jeffsponaugle/rsc68k/documents/FLIR0329.jpg

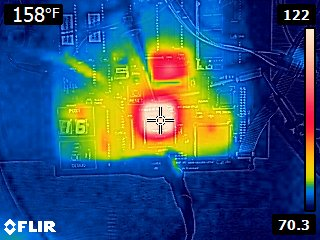
documents/FLIR0329.jpg
