jeffsponaugle/rsc68k/documents/AN-1259_System_Design_and_Layout_Techniques_for_Noise_reduction_in_MCU-based_systems.pdf

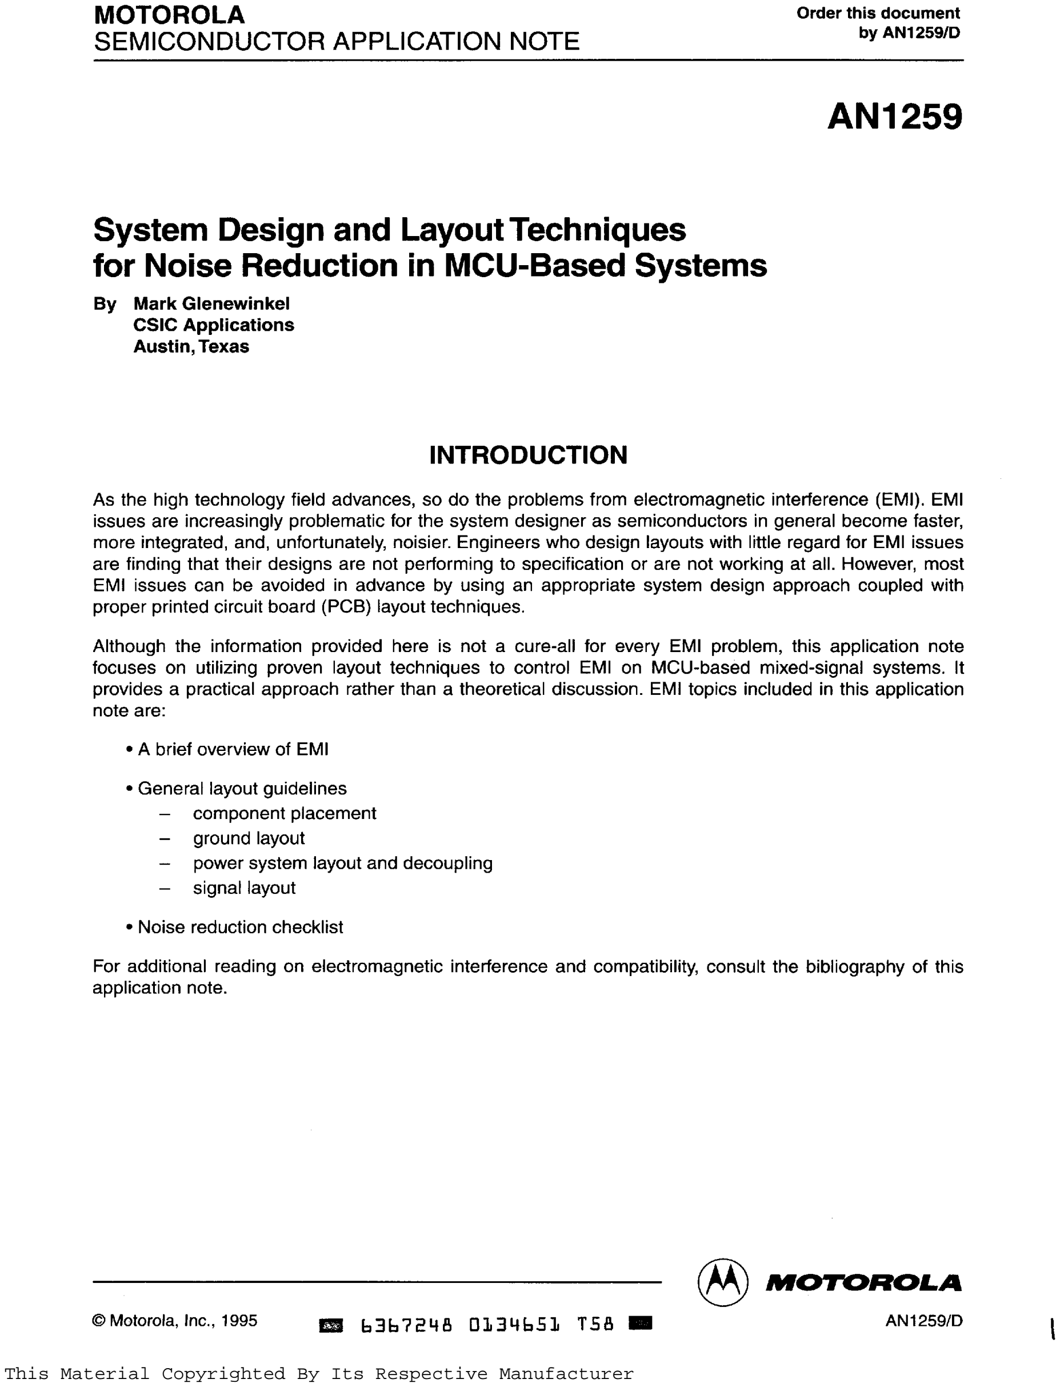
[picture p3: page 1]

This Material Copyrighted By Its Respective Manufacturer

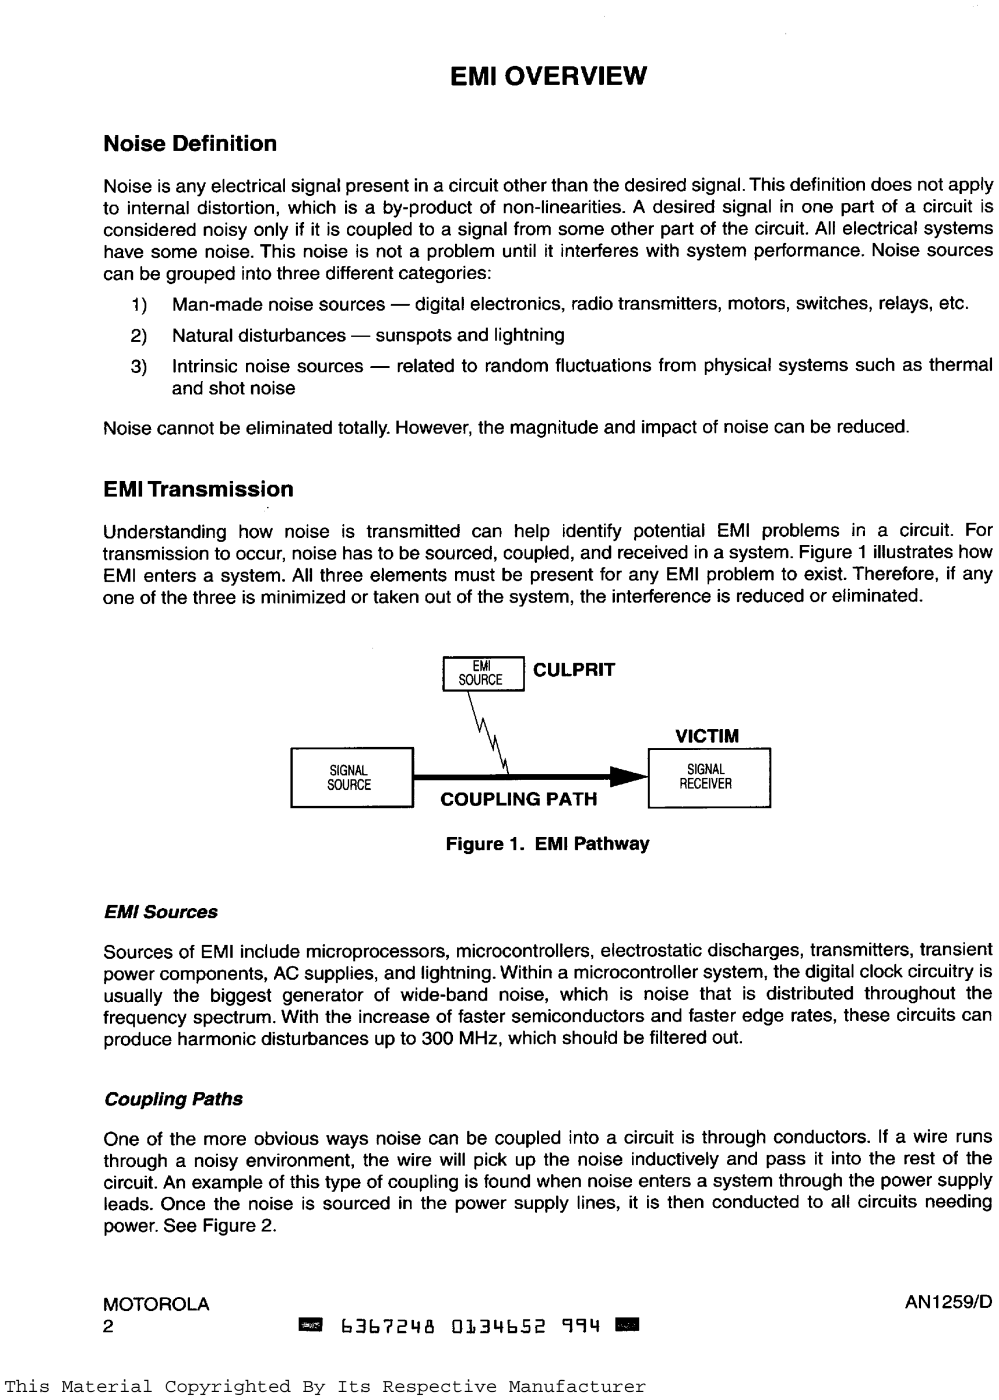
[picture p4: page 2]
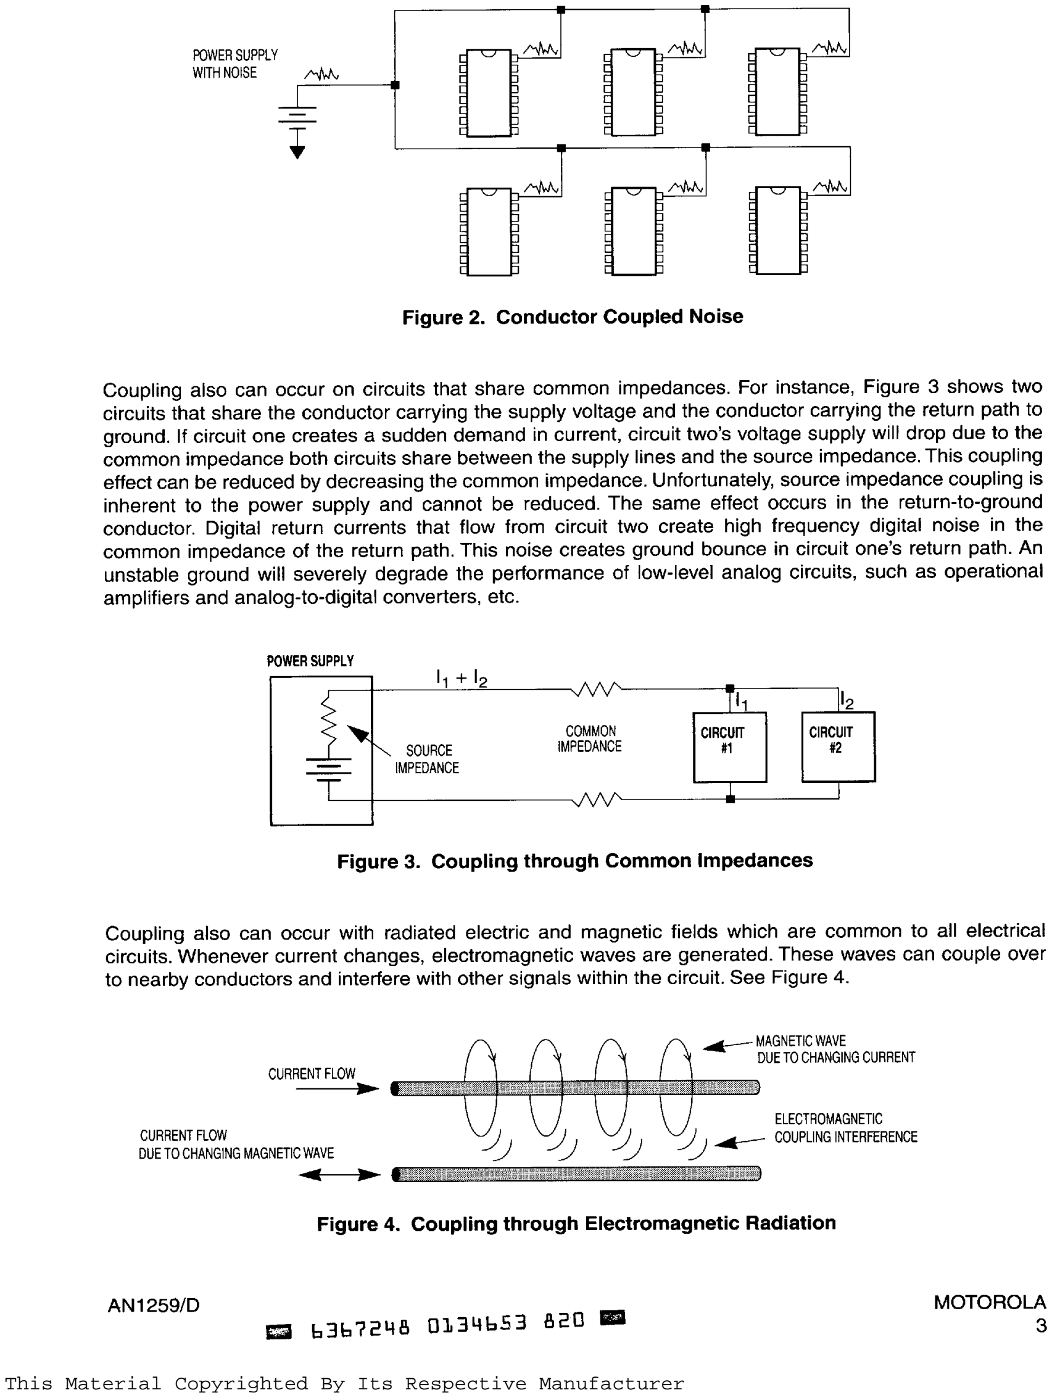
[picture p5: page 3]
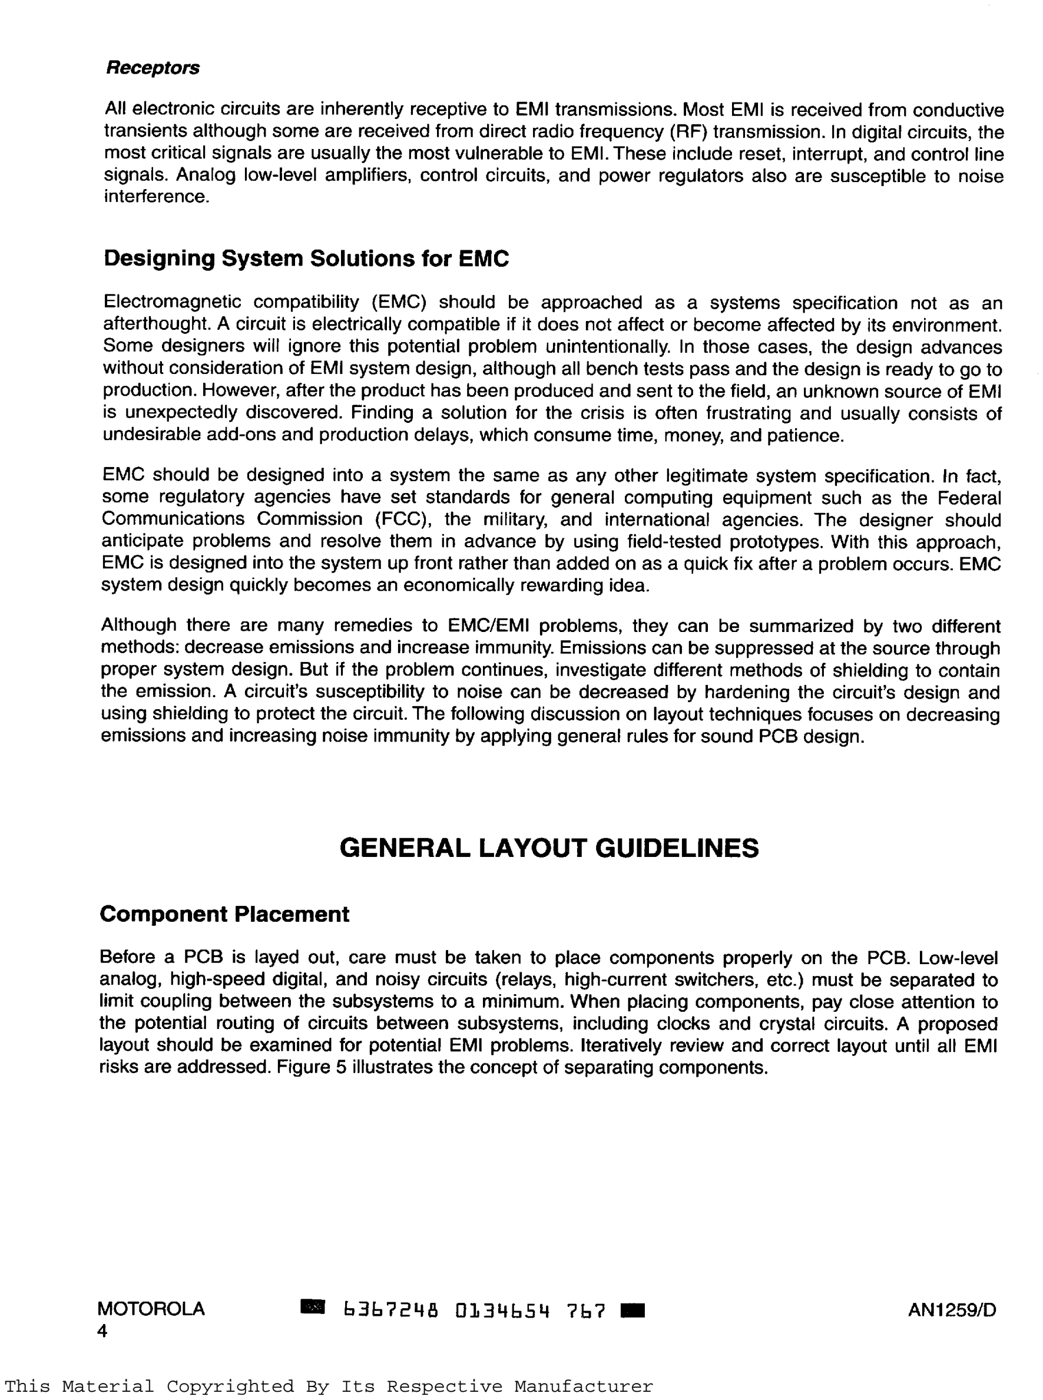
[picture p6: page 4]
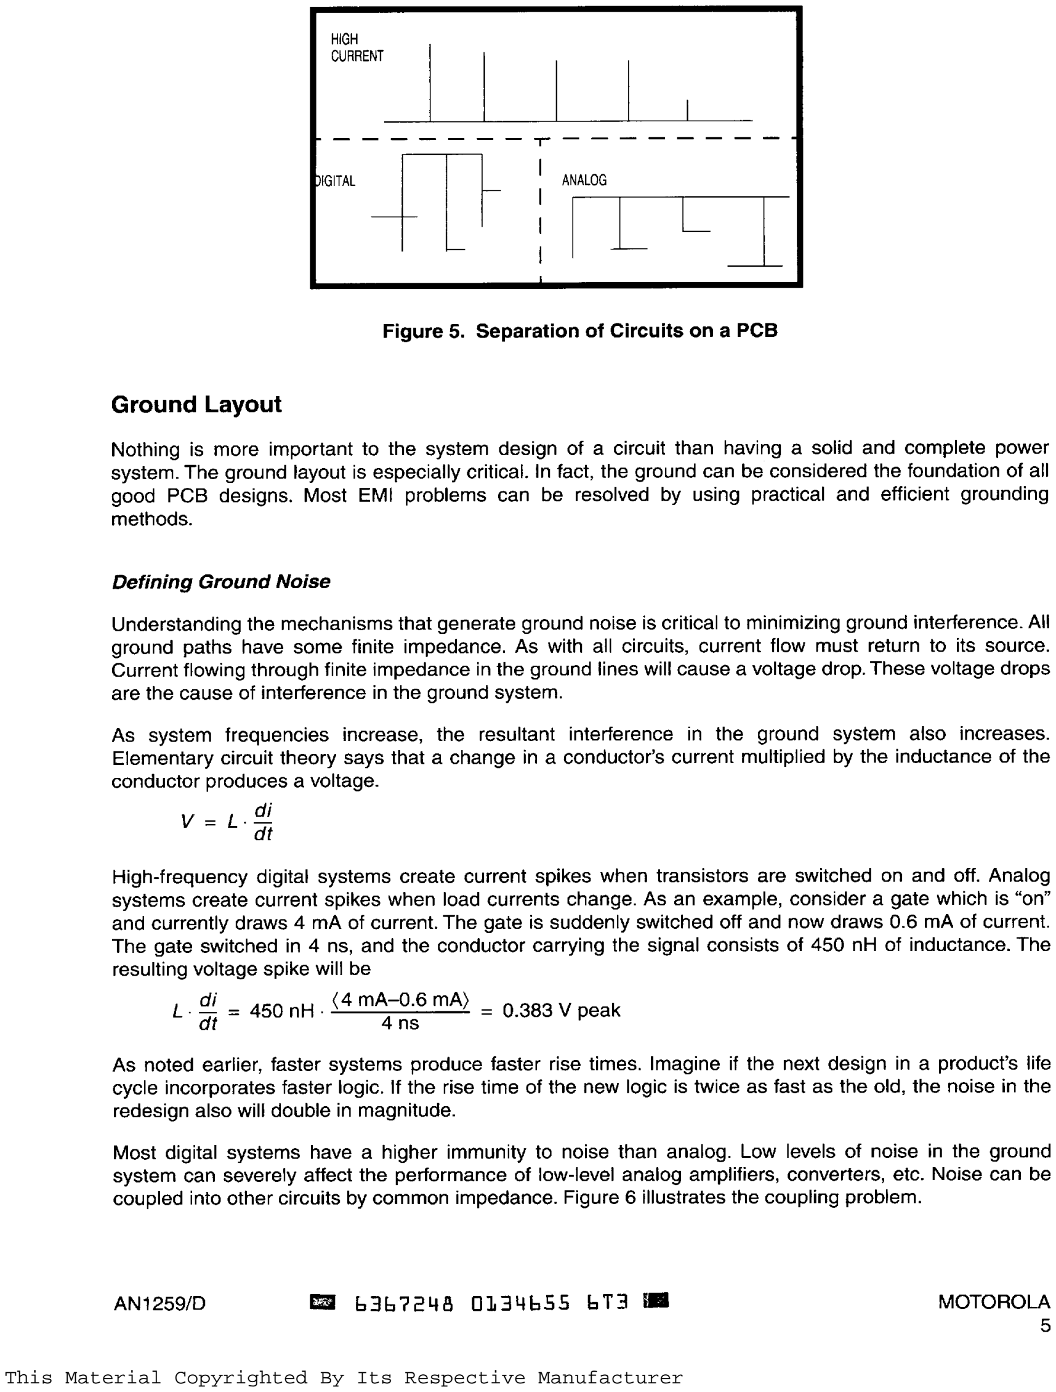
[picture p7: page 5]
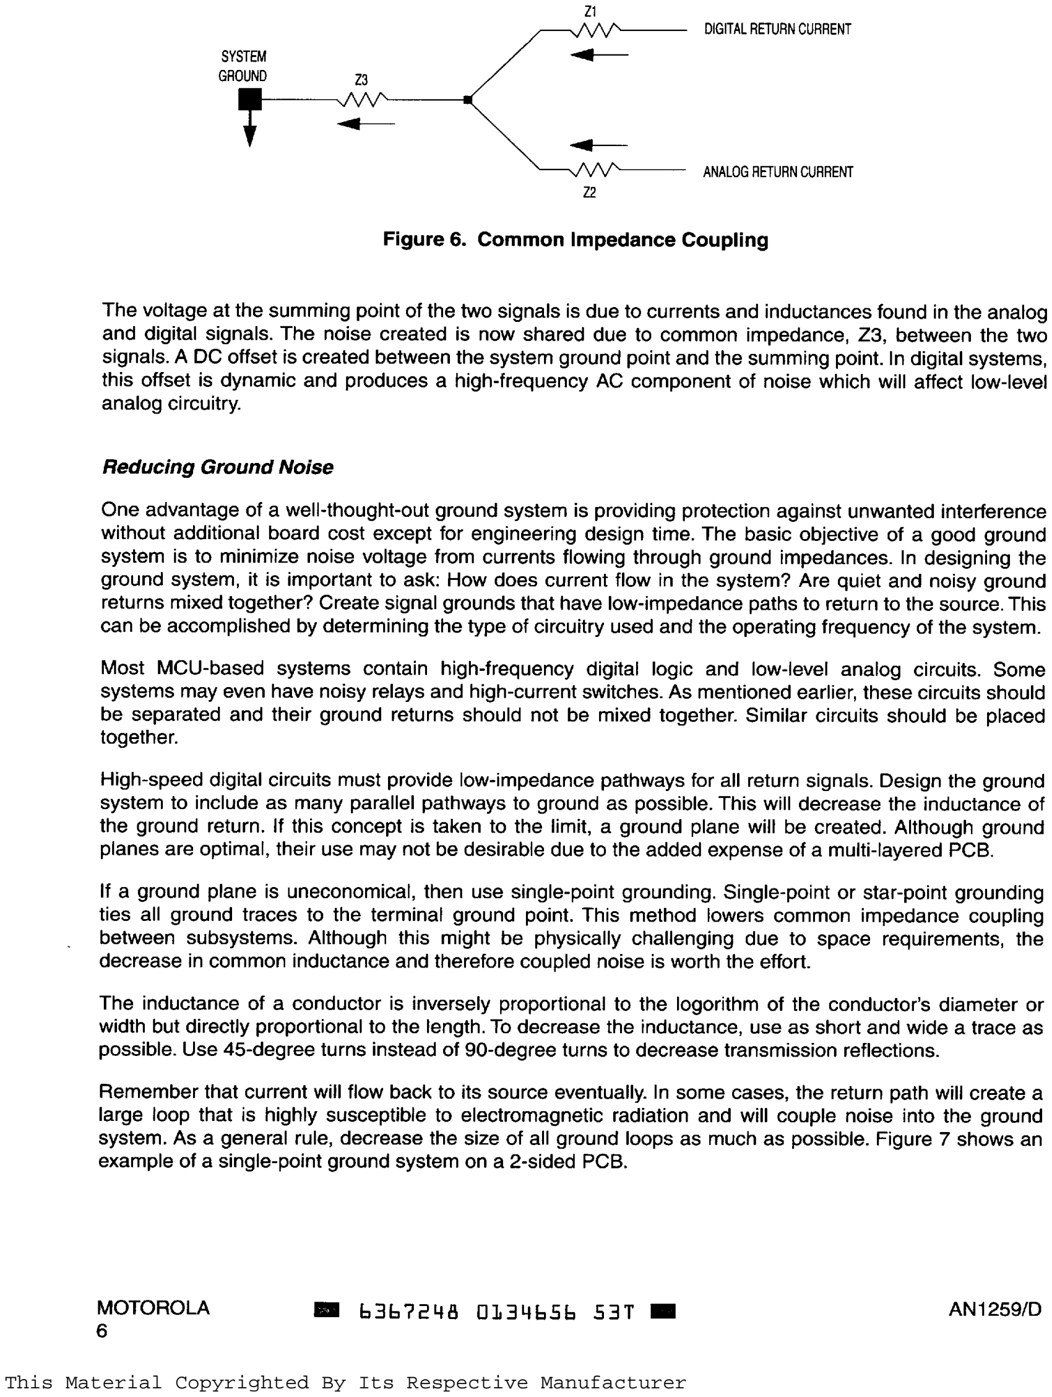
[picture p8: page 6]
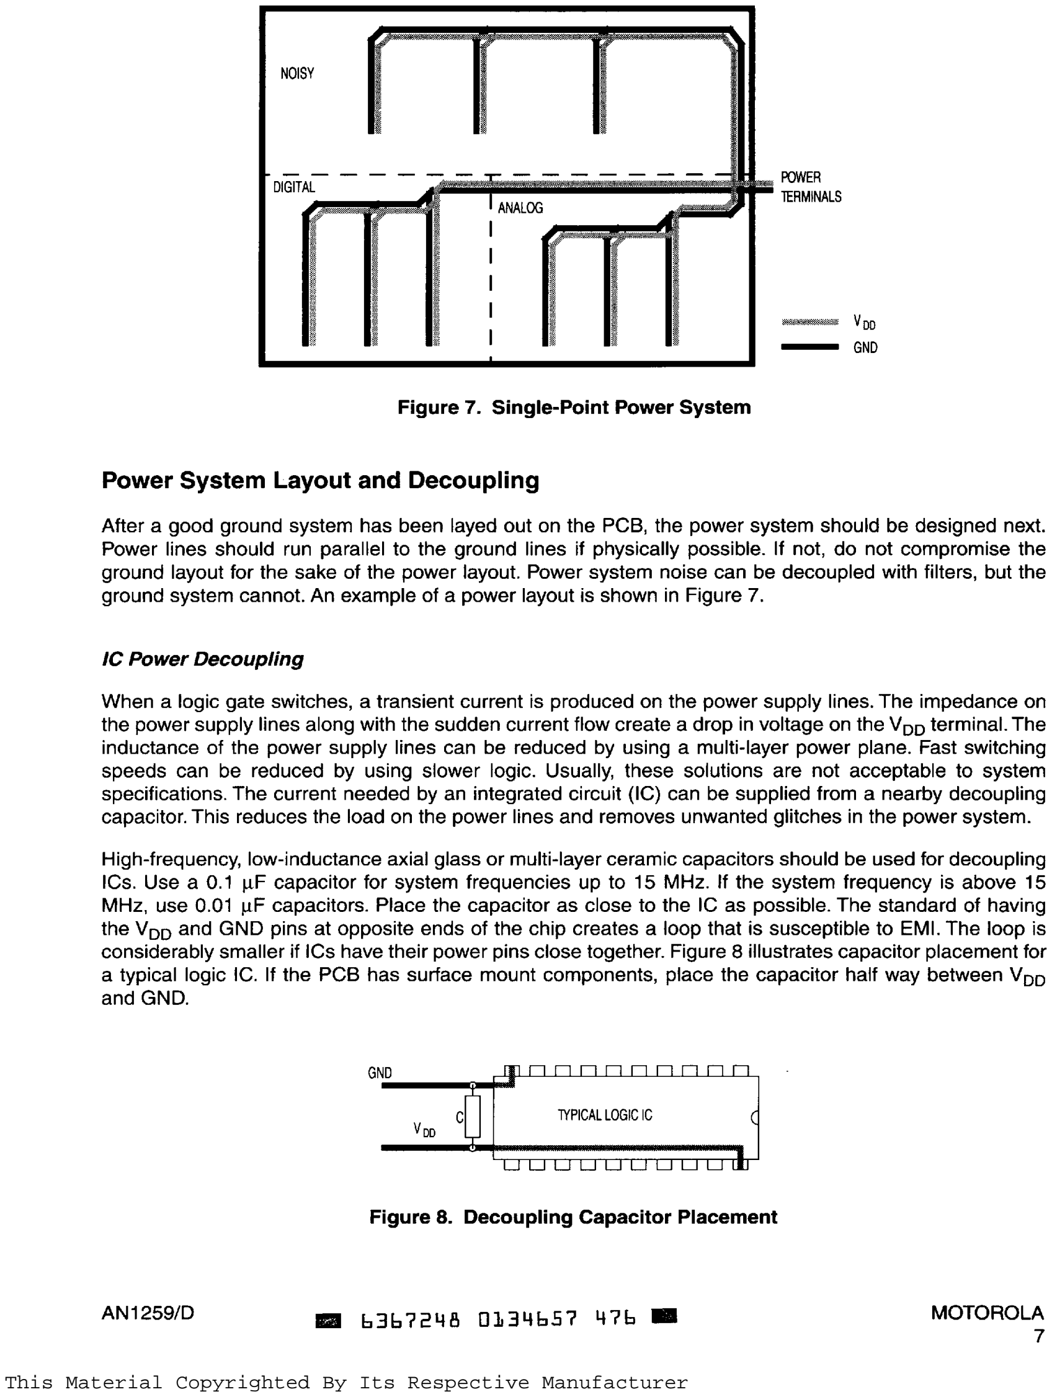
[picture p9: page 7]
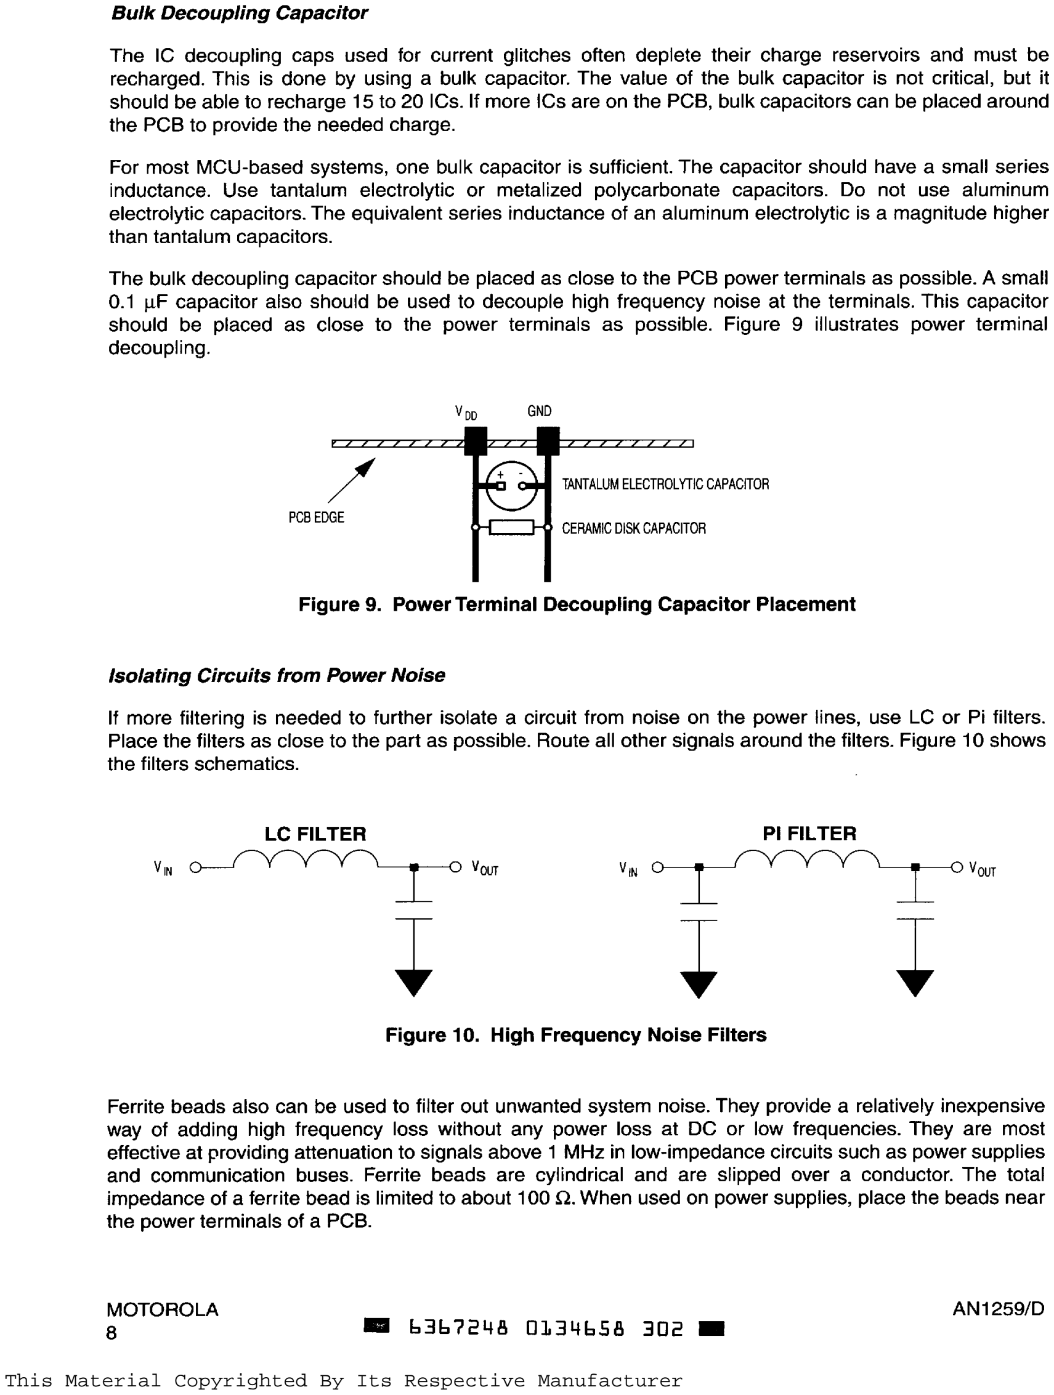
[picture p10: page 8]
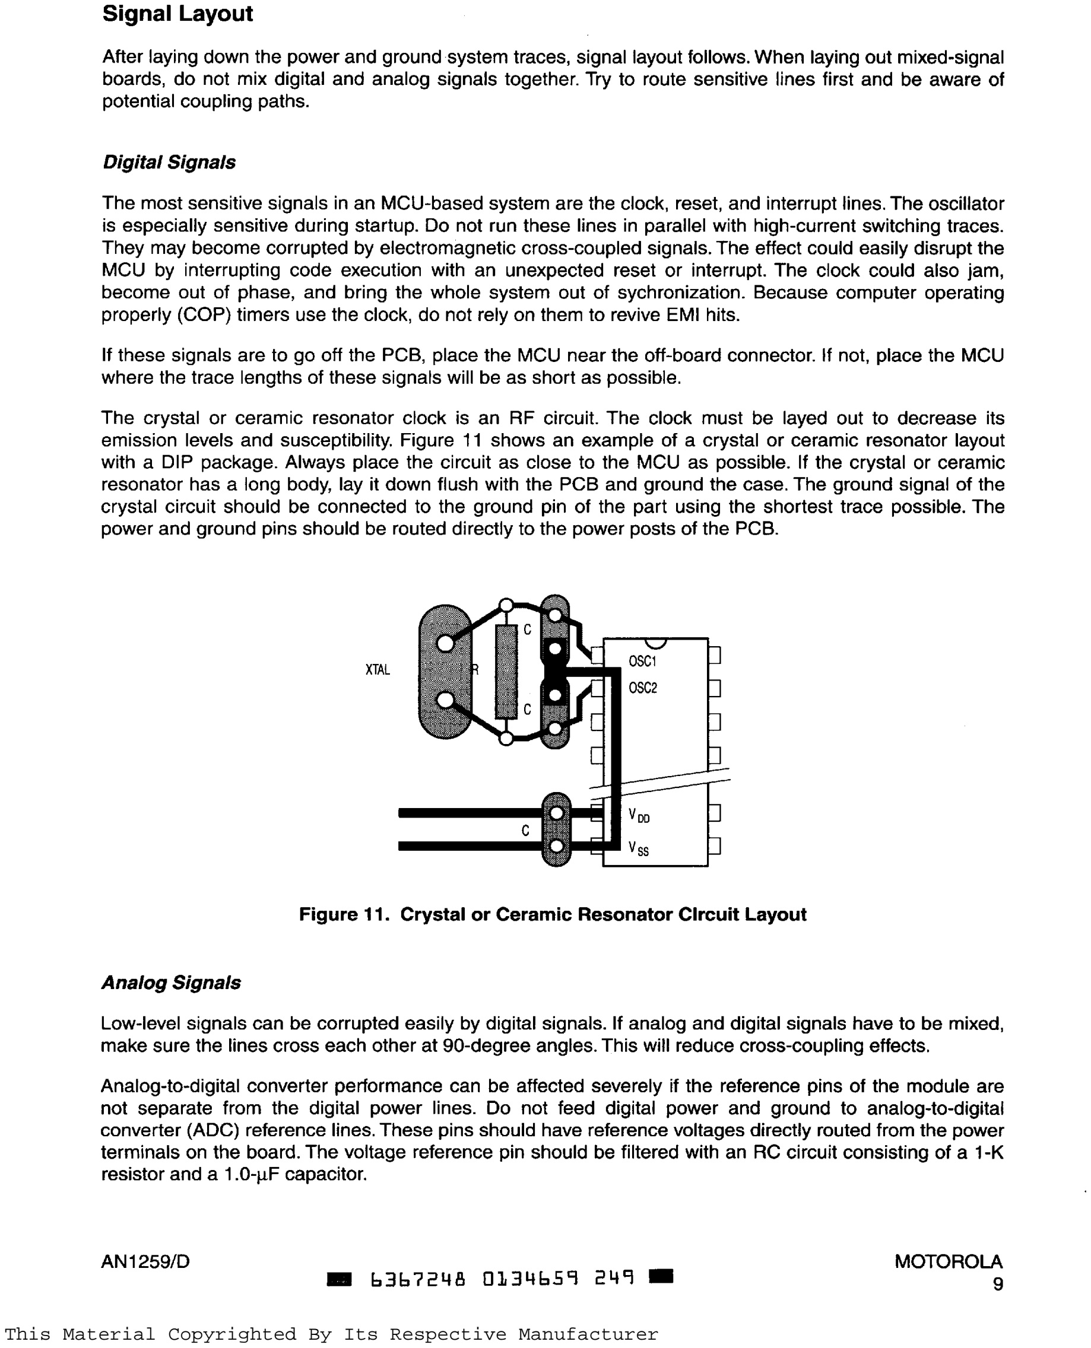
[picture p11: page 9]
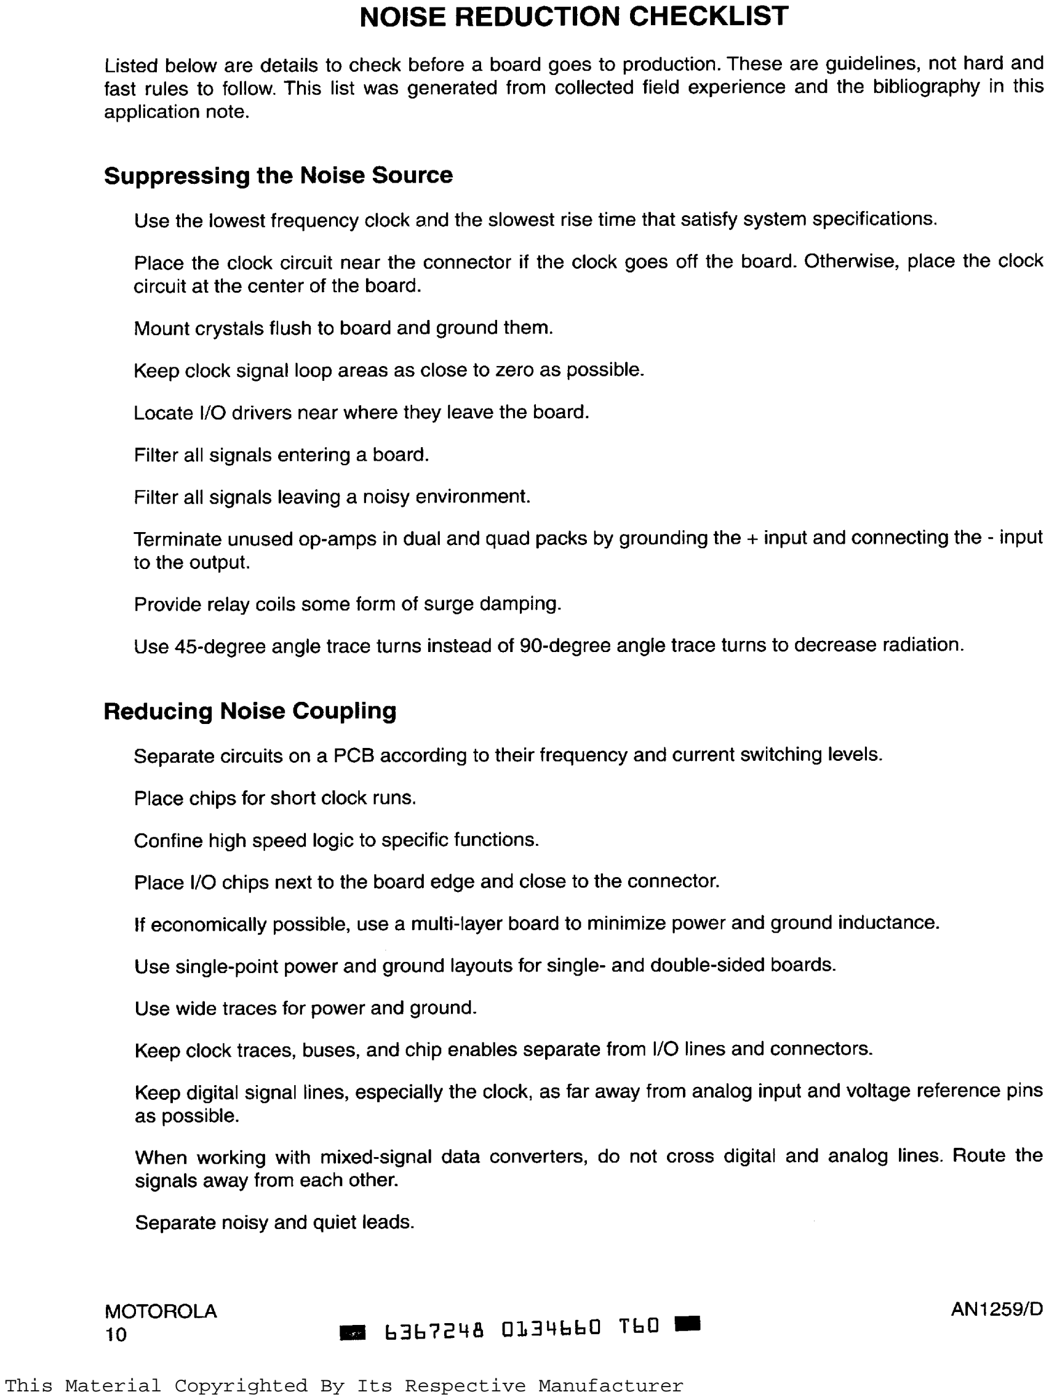
[picture p12: page 10]
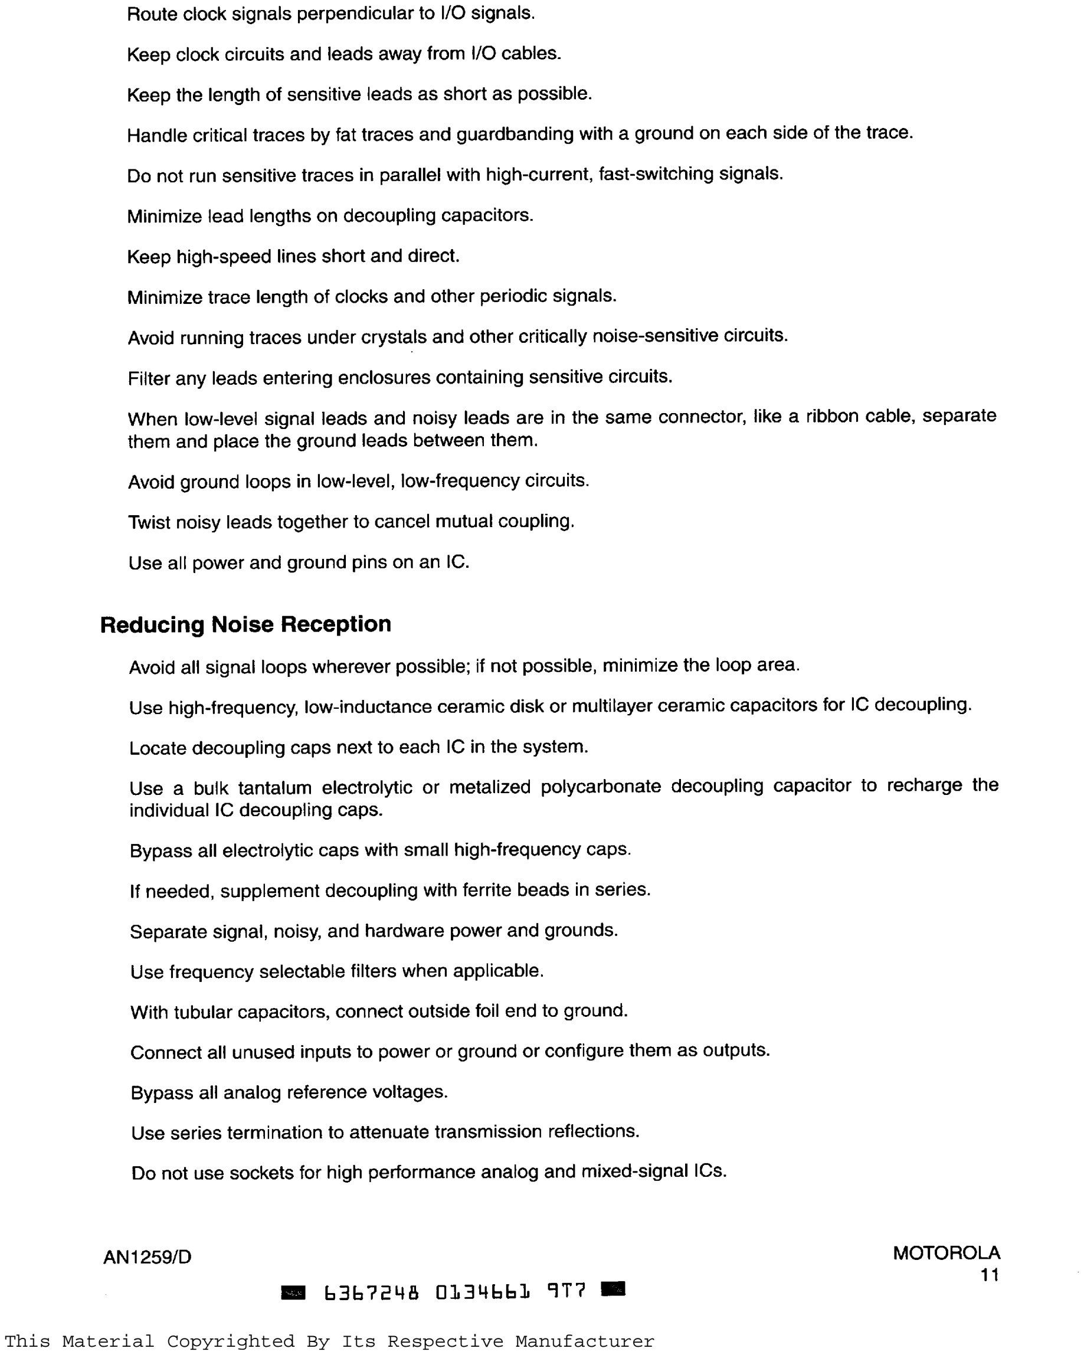
[picture p13: page 11]
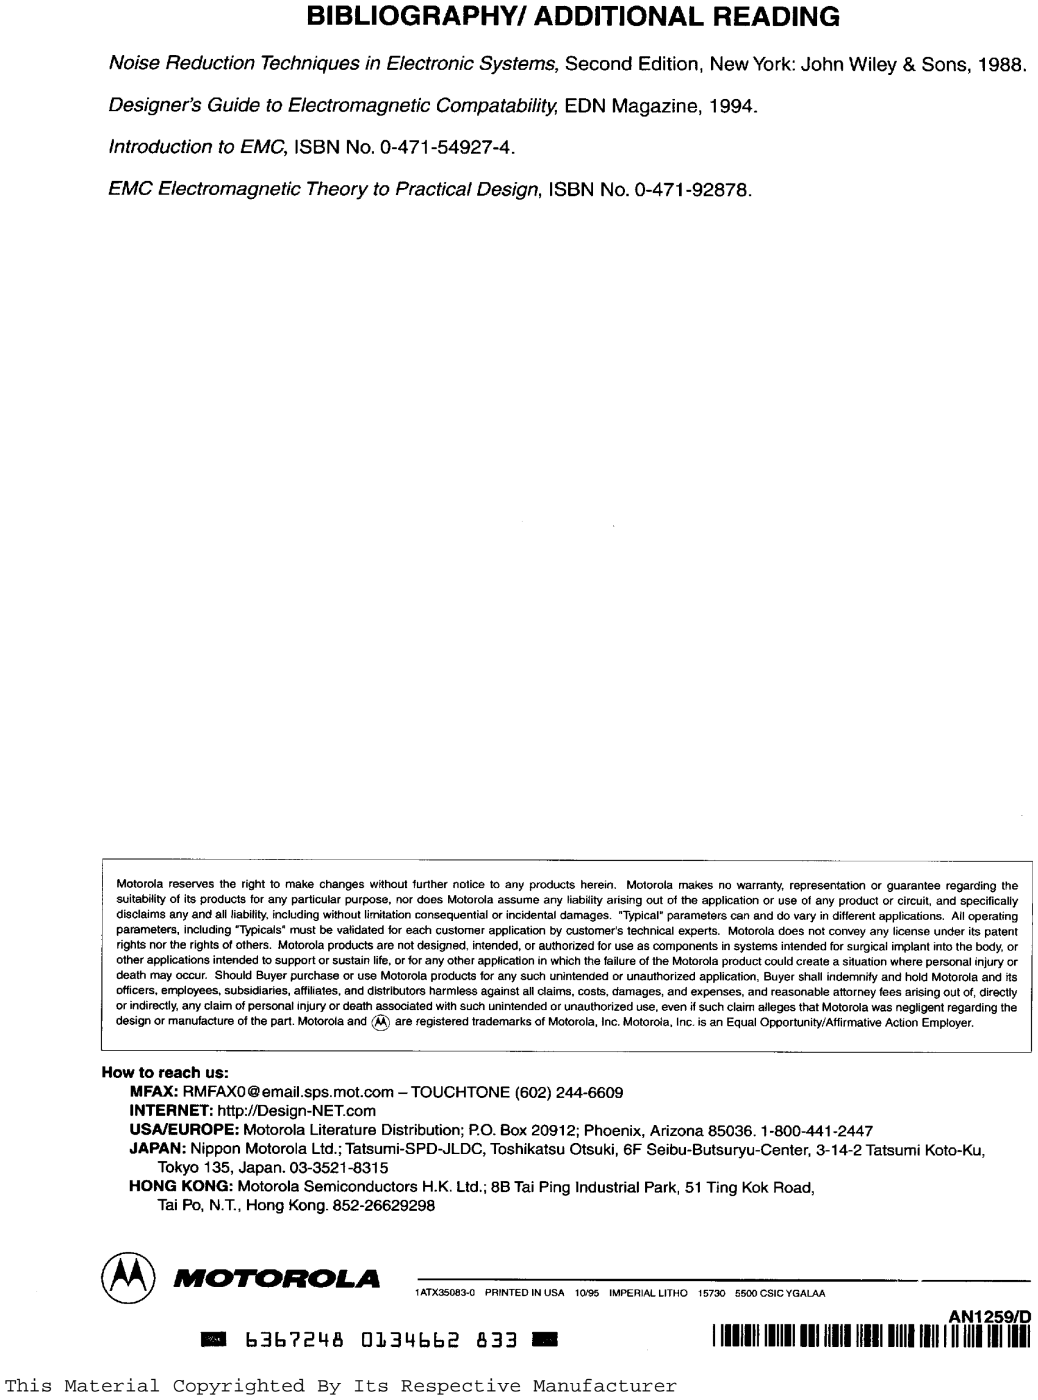
[picture p14: page 12]
