jeffsponaugle/rsc68k/documents/500-PLCC-28-32_eng_tds.pdf

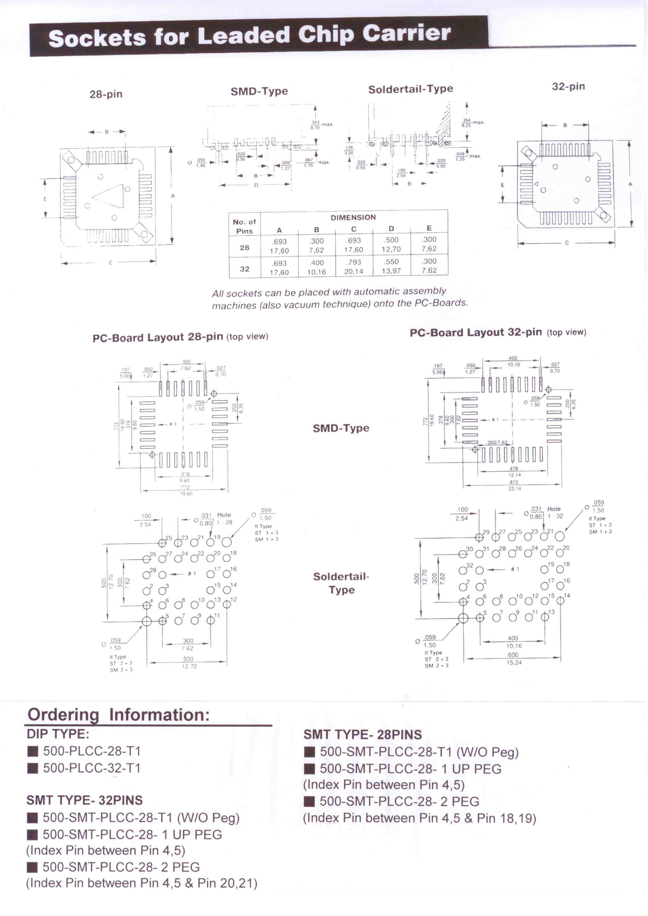
[picture p15: page 1]
