jeffsponaugle/rsc68k/cpld/ATXBoardV1/BRIDGE_CPLD/scope/C32-C16-REFGNT-CPU0REQ.png

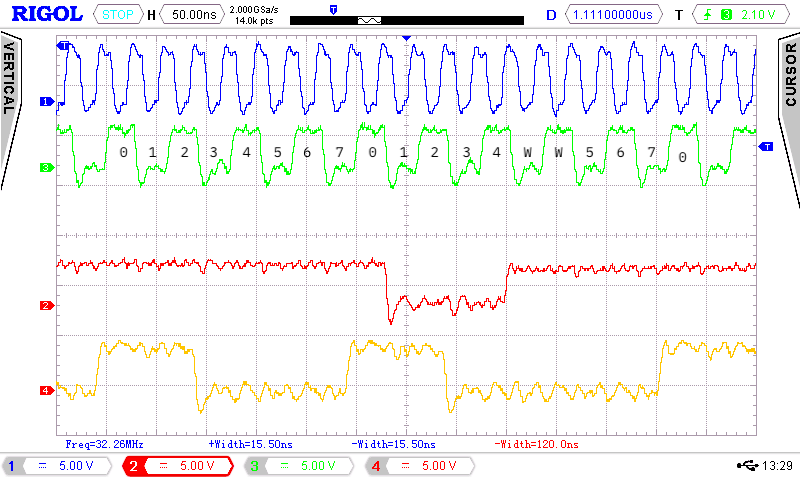
cpld/ATXBoardV1/BRIDGE_CPLD/scope/C32-C16-REFGNT-CPU0REQ.png
