jeffsponaugle/rsc68k/cpld/ATXBoardV1/BRIDGE_CPLD/scope/CLK16-AS-RGNT-CGNTd.png

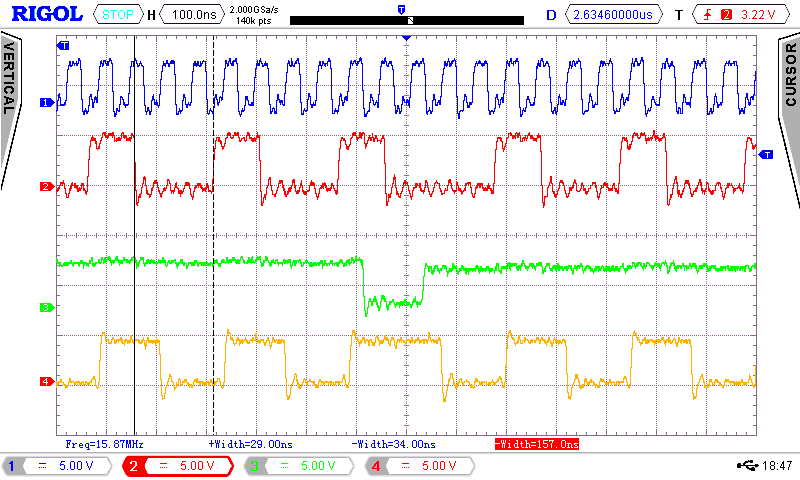
cpld/ATXBoardV1/BRIDGE_CPLD/scope/CLK16-AS-RGNT-CGNTd.png
