jeffsponaugle/rsc68k/cpld/ATXBoardV1/BRIDGE_CPLD/scope/CLK16-AS-RGNT-CGNTf.png

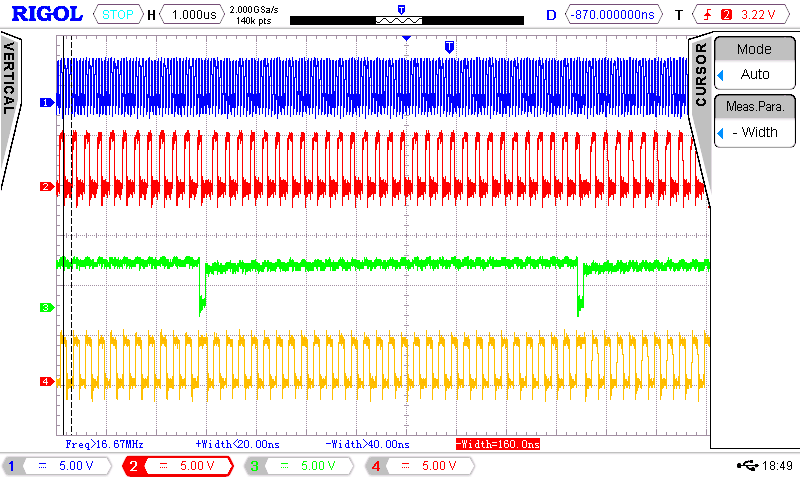
cpld/ATXBoardV1/BRIDGE_CPLD/scope/CLK16-AS-RGNT-CGNTf.png
