jeffsponaugle/rsc68k/cpld/ATXBoardV1/BRIDGE_CPLD/scope/CLK32-AS-REQ-GNTa1.png

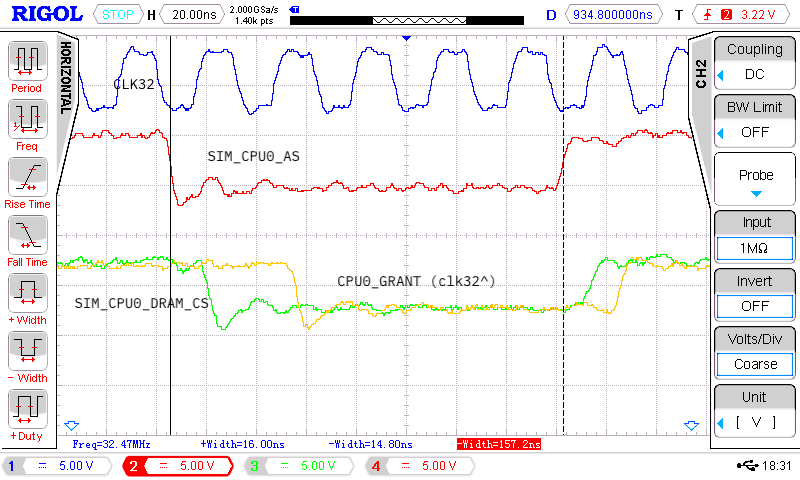
cpld/ATXBoardV1/BRIDGE_CPLD/scope/CLK32-AS-REQ-GNTa1.png
