jeffsponaugle/rsc68k/cpld/ATXBoardV1/BRIDGE_CPLD/scope/CLK32-AS-RGNT-CGNTa.png

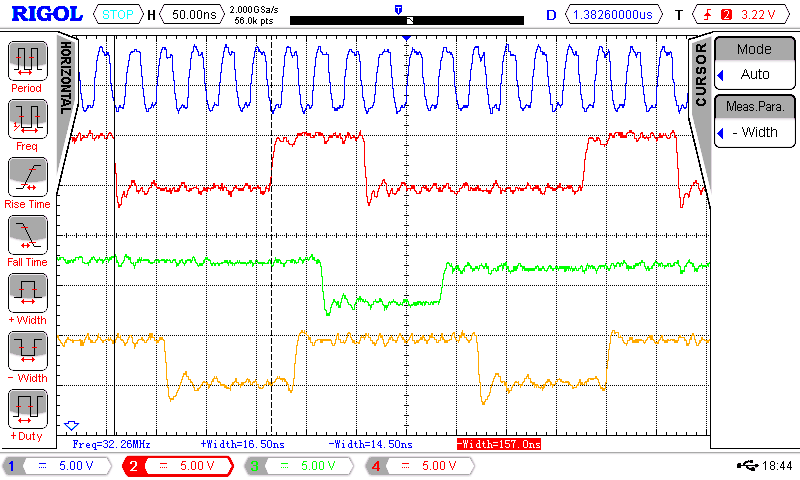
cpld/ATXBoardV1/BRIDGE_CPLD/scope/CLK32-AS-RGNT-CGNTa.png
