jeffsponaugle/rsc68k/cpld/ATXBoardV1/BRIDGE_CPLD/scope/CLK-AS-REQ-GNTb.png

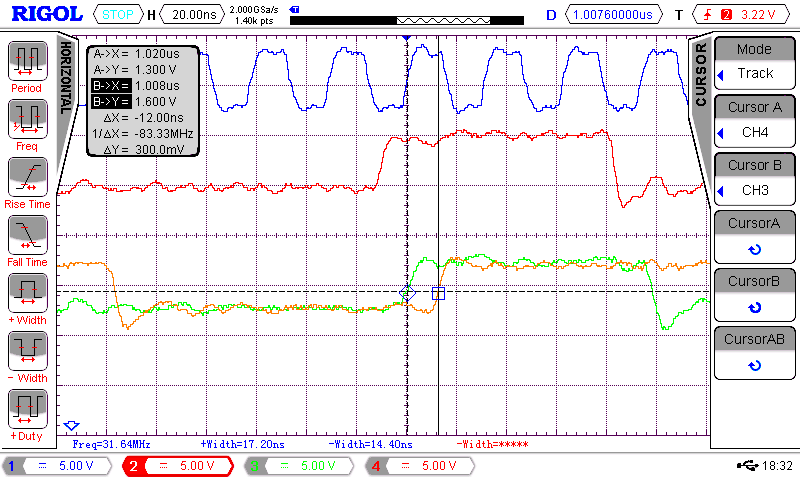
cpld/ATXBoardV1/BRIDGE_CPLD/scope/CLK-AS-REQ-GNTb.png
