jeffsponaugle/rsc68k/documents/16MhzDRAMREFESH1.png

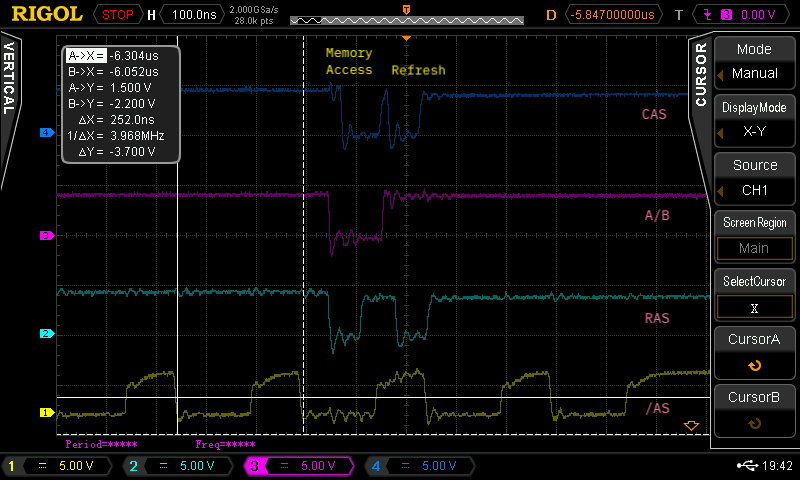
documents/16MhzDRAMREFESH1.png
