jeffsponaugle/rsc68k/documents/16MhzDRAMREFRESH2.png

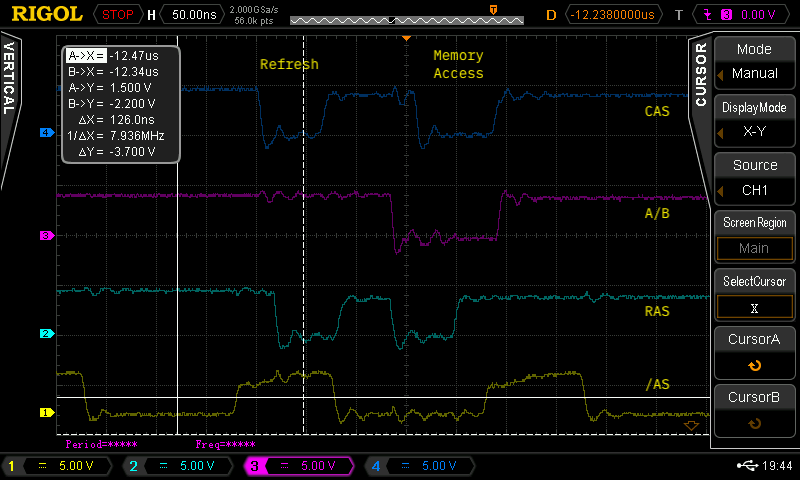
documents/16MhzDRAMREFRESH2.png
