jeffsponaugle/rsc68k/documents/42258354_10155493502805047_6035253907939131392_n (1).jpg

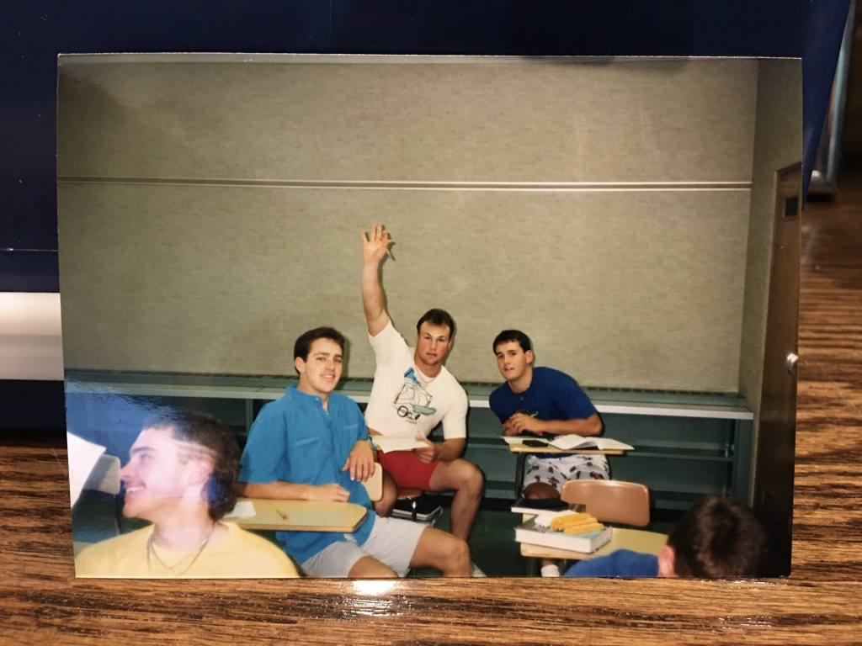
documents/42258354_10155493502805047_6035253907939131392_n (1).jpg
