jeffsponaugle/rsc68k/documents/42274475_10217530068780495_6191780692506968064_n.jpg

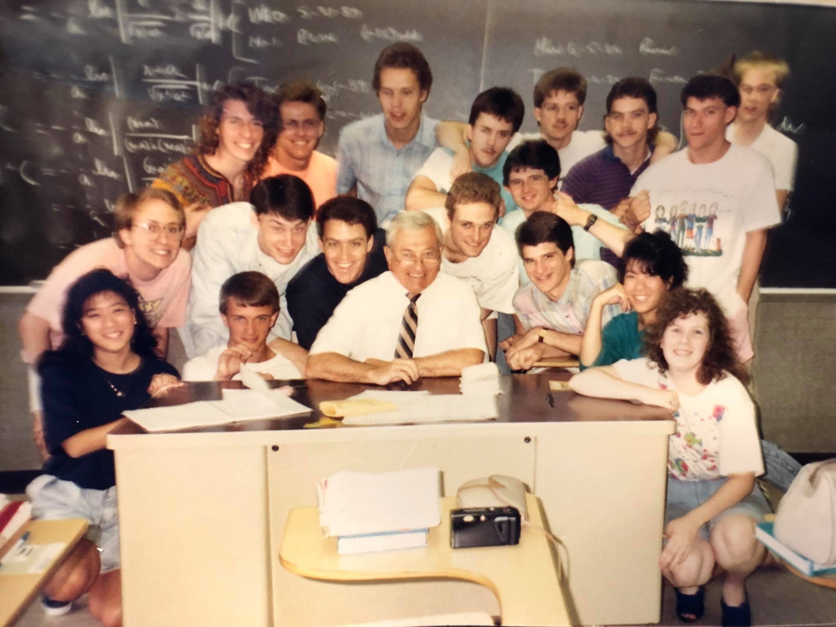
documents/42274475_10217530068780495_6191780692506968064_n.jpg
