jeffsponaugle/rsc68k/documents/DRAMTesting/16MHZ-AS-Average.png

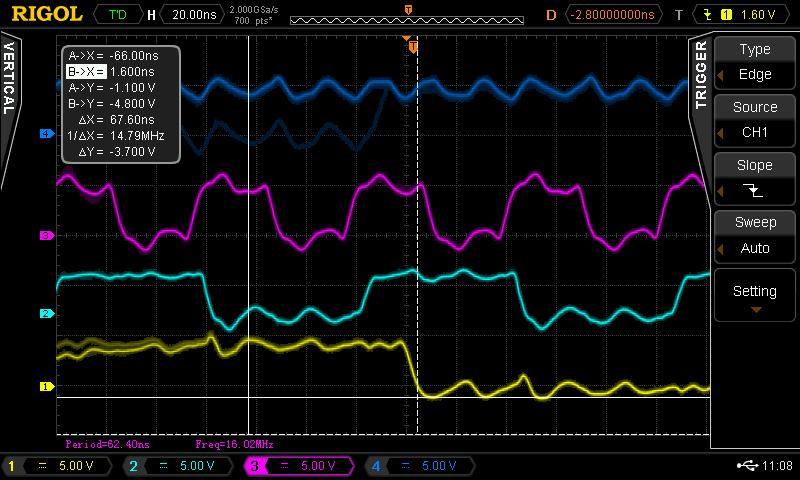
documents/DRAMTesting/16MHZ-AS-Average.png
