jeffsponaugle/rsc68k/documents/DRAMTesting/16MHZ-AS.png

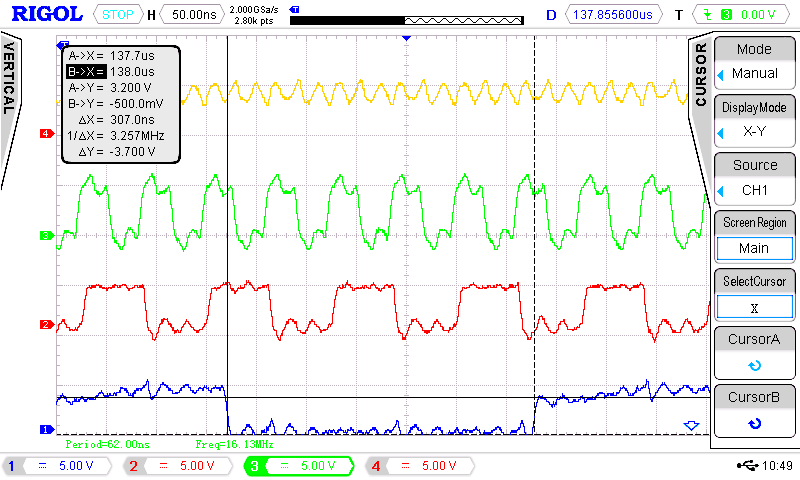
documents/DRAMTesting/16MHZ-AS.png
