jeffsponaugle/rsc68k/documents/DRAMTesting/20MHZ-AS.png

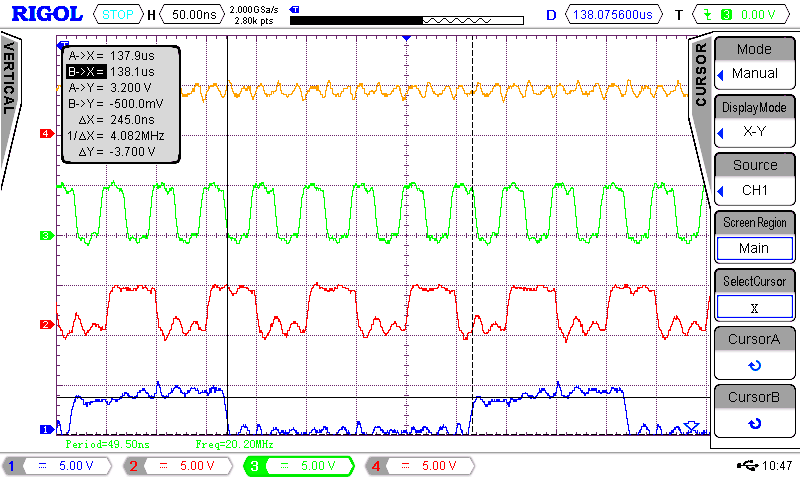
documents/DRAMTesting/20MHZ-AS.png
