jeffsponaugle/rsc68k/documents/DRAMTesting/24MHZ-AS.png

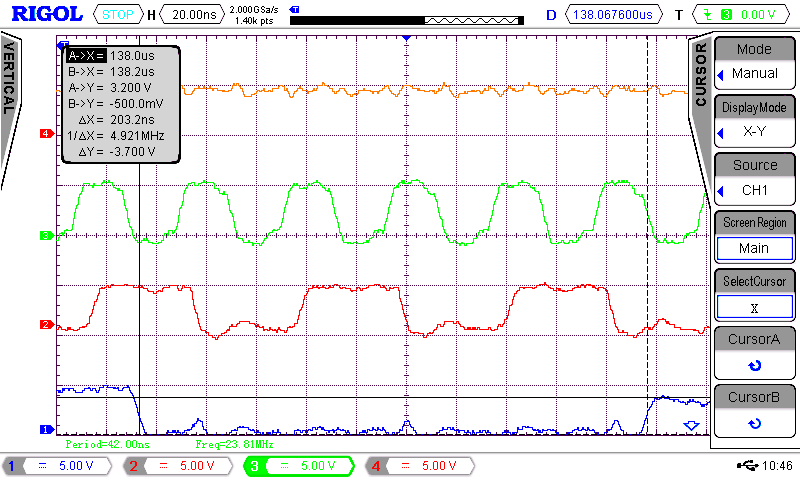
documents/DRAMTesting/24MHZ-AS.png
