jeffsponaugle/rsc68k/documents/DRAMTesting/32MHZ-AS.png

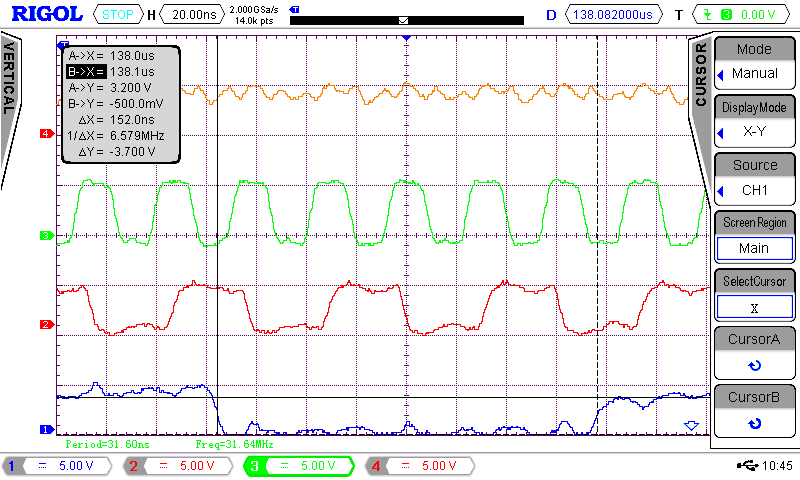
documents/DRAMTesting/32MHZ-AS.png
