jeffsponaugle/rsc68k/documents/DRAMTesting/32MHZ-CASTiming2.png

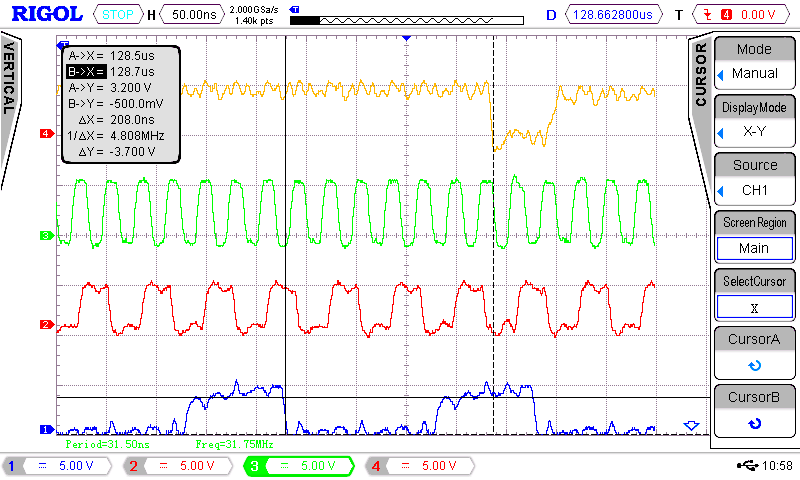
documents/DRAMTesting/32MHZ-CASTiming2.png
