jeffsponaugle/rsc68k/documents/DRAMTesting/rig/16MHZ-AS.png

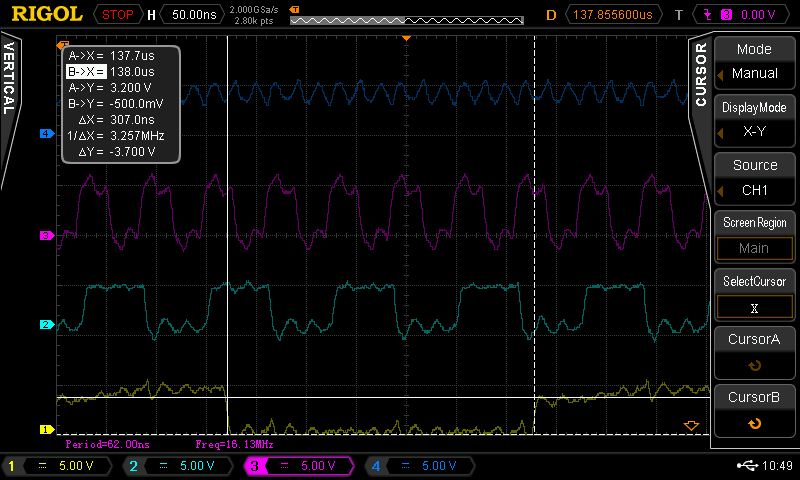
documents/DRAMTesting/rig/16MHZ-AS.png
