jeffsponaugle/rsc68k/documents/DRAMTimingSS/AccBeforeRefresh/ASHighToASLow.png

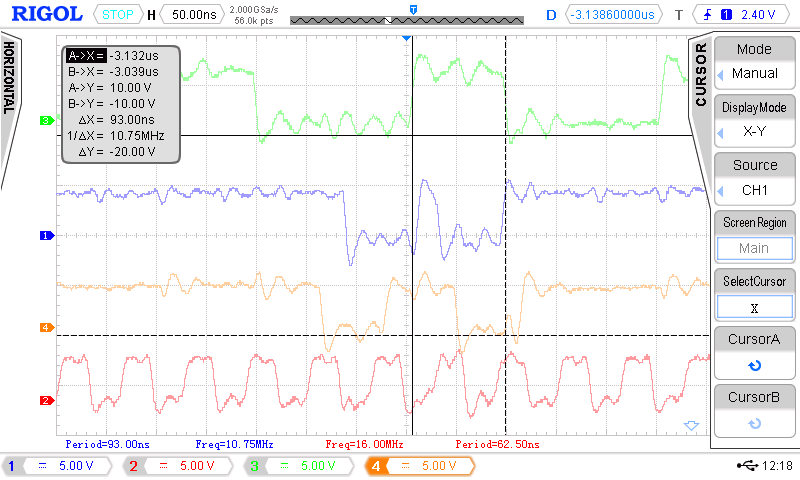
documents/DRAMTimingSS/AccBeforeRefresh/ASHighToASLow.png
