jeffsponaugle/rsc68k/documents/DRAMTimingSS/AccBeforeRefresh/ASHighToCASHigh.png

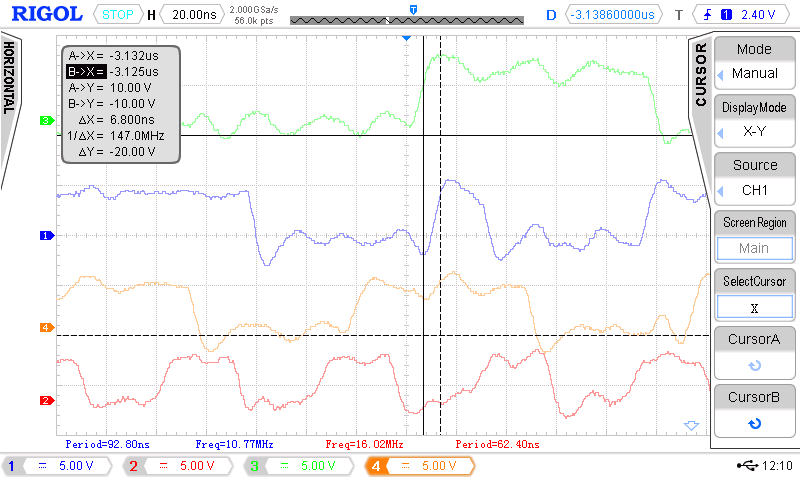
documents/DRAMTimingSS/AccBeforeRefresh/ASHighToCASHigh.png
