jeffsponaugle/rsc68k/documents/DRAMTimingSS/AccBeforeRefresh/ASHighToCASRLow.png

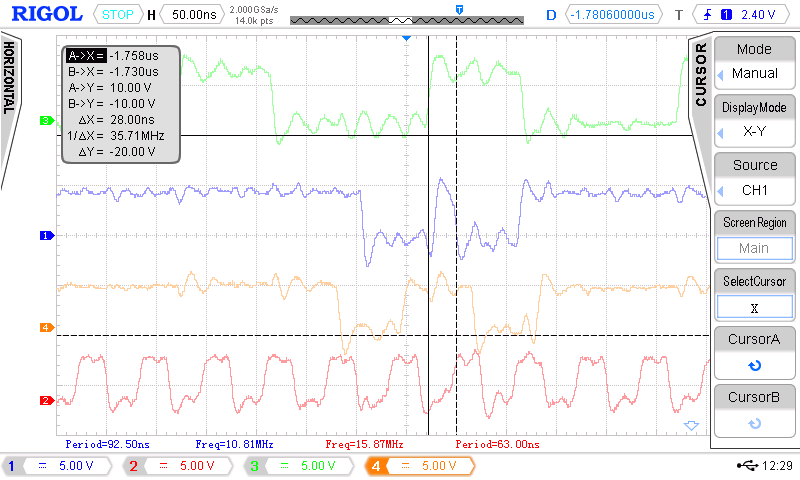
documents/DRAMTimingSS/AccBeforeRefresh/ASHighToCASRLow.png
