jeffsponaugle/rsc68k/documents/DRAMTimingSS/AccBeforeRefresh/ASLowToCASHigh.png

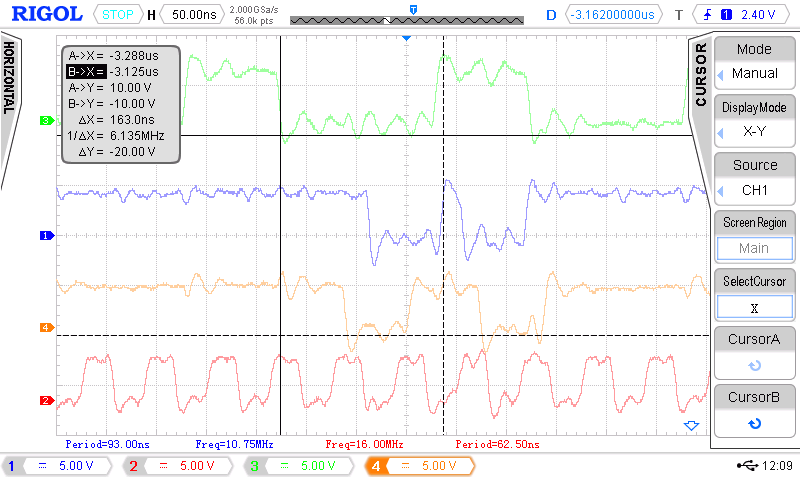
documents/DRAMTimingSS/AccBeforeRefresh/ASLowToCASHigh.png
