jeffsponaugle/rsc68k/documents/DRAMTimingSS/AccBeforeRefresh/ASLowToCLK16Low.png

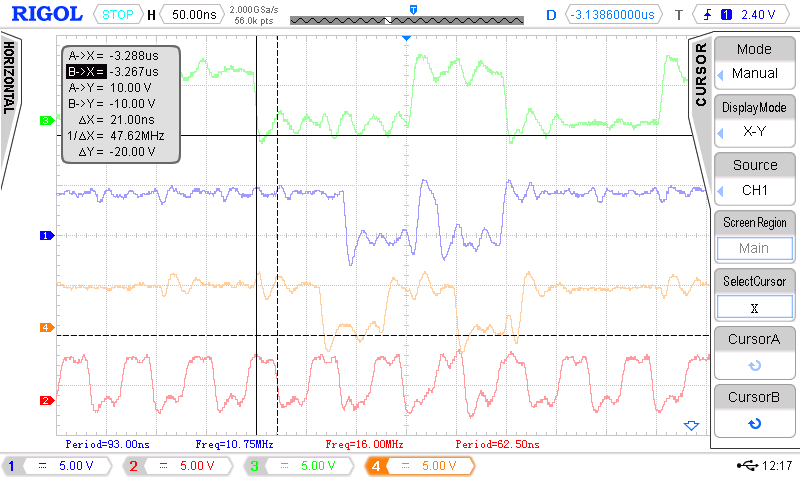
documents/DRAMTimingSS/AccBeforeRefresh/ASLowToCLK16Low.png
