jeffsponaugle/rsc68k/documents/DRAMTimingSS/AccBeforeRefresh/ASLowToRASLow.png

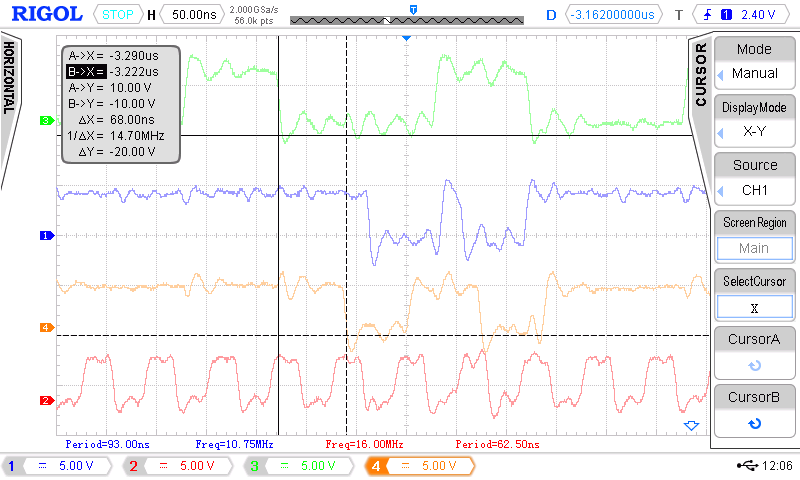
documents/DRAMTimingSS/AccBeforeRefresh/ASLowToRASLow.png
