jeffsponaugle/rsc68k/documents/DRAMTimingSS/AccBeforeRefresh/ASLowvsCLK16.png

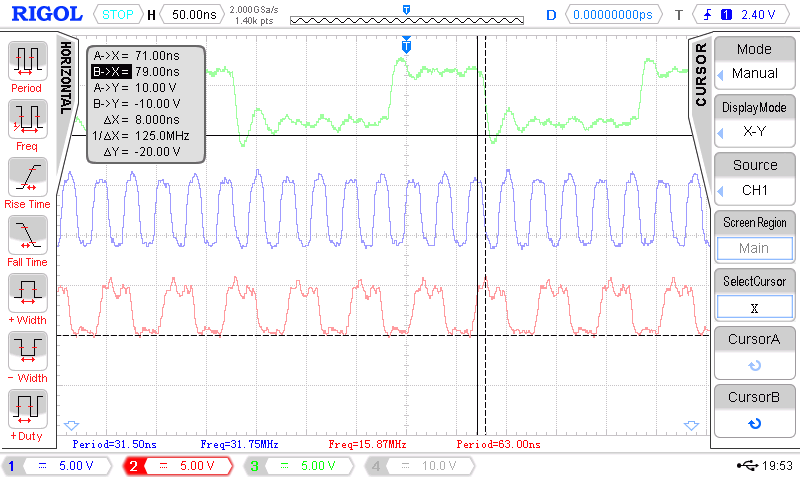
documents/DRAMTimingSS/AccBeforeRefresh/ASLowvsCLK16.png
