jeffsponaugle/rsc68k/documents/DRAMTimingSS/AccBeforeRefresh/ASLowvsCLK32.png

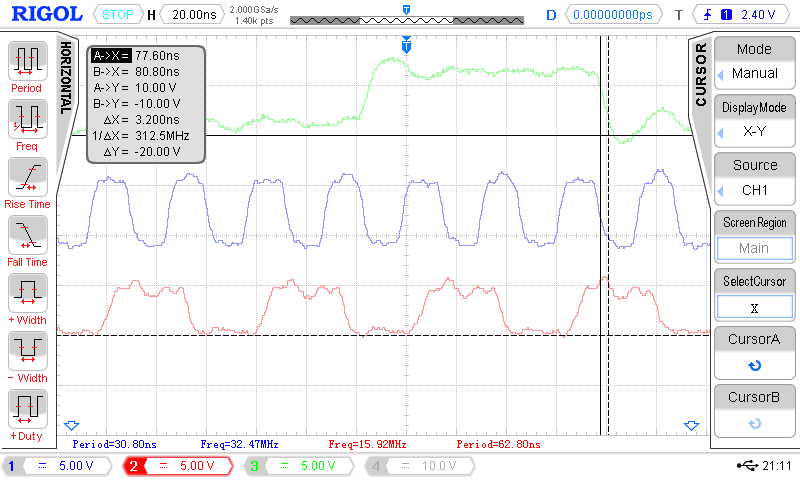
documents/DRAMTimingSS/AccBeforeRefresh/ASLowvsCLK32.png
