jeffsponaugle/rsc68k/documents/DRAMTimingSS/AccBeforeRefresh/CASHightoCASRLow.png

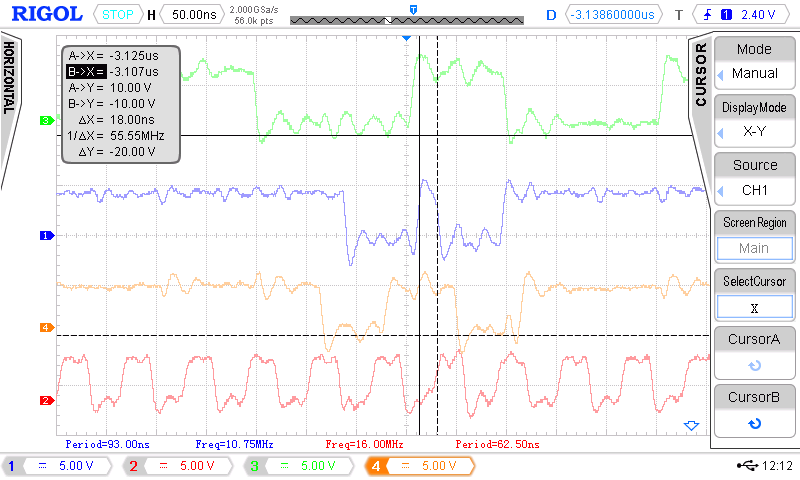
documents/DRAMTimingSS/AccBeforeRefresh/CASHightoCASRLow.png
