jeffsponaugle/rsc68k/documents/DRAMTimingSS/AccBeforeRefresh/CASWidthAccess.png

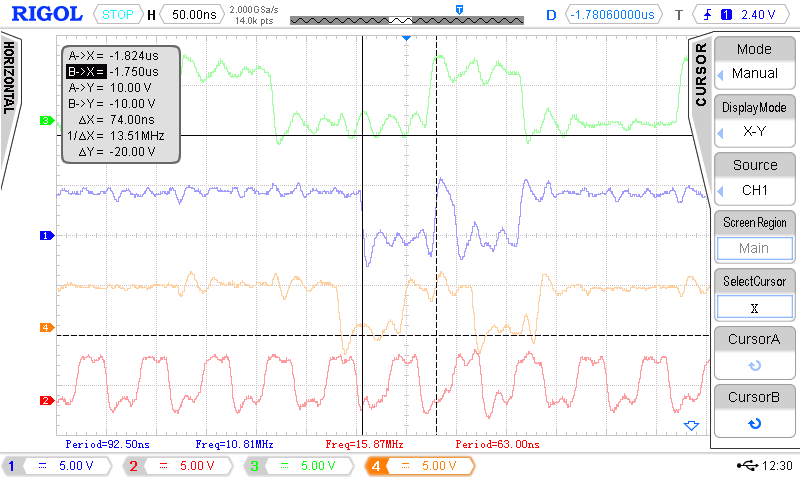
documents/DRAMTimingSS/AccBeforeRefresh/CASWidthAccess.png
