jeffsponaugle/rsc68k/documents/DRAMTimingSS/AccBeforeRefresh/CASWidthRefresh.png

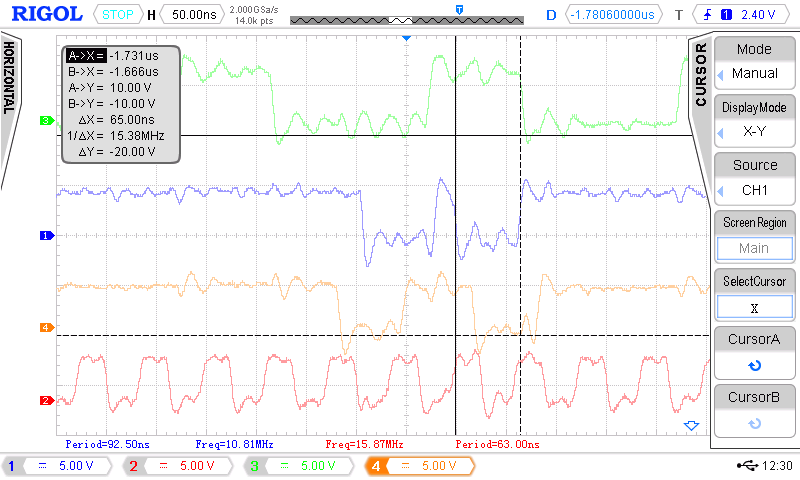
documents/DRAMTimingSS/AccBeforeRefresh/CASWidthRefresh.png
