jeffsponaugle/rsc68k/documents/DRAMTimingSS/AccBeforeRefresh/CLK16CLK32Lag2.png

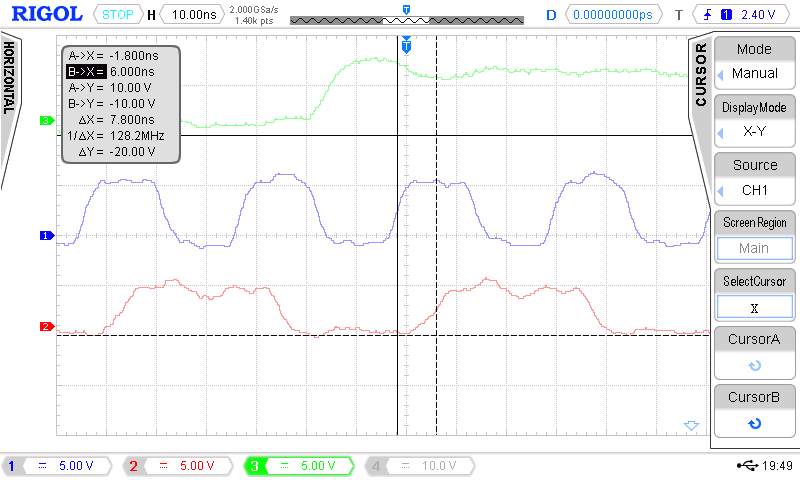
documents/DRAMTimingSS/AccBeforeRefresh/CLK16CLK32Lag2.png
