jeffsponaugle/rsc68k/documents/DRAMTimingSS/AccBeforeRefresh/CLK16CLK32Lag.png

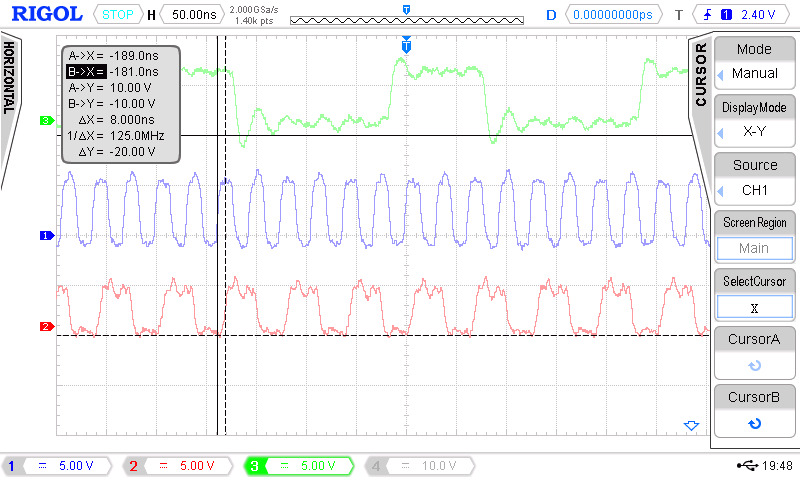
documents/DRAMTimingSS/AccBeforeRefresh/CLK16CLK32Lag.png
