jeffsponaugle/rsc68k/documents/DRAMTimingSS/AccBeforeRefresh/CLK16HighToRASLow.png

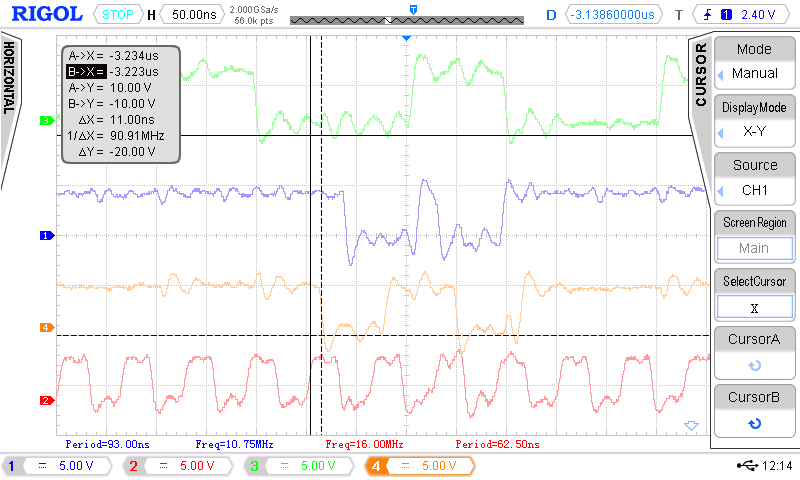
documents/DRAMTimingSS/AccBeforeRefresh/CLK16HighToRASLow.png
