jeffsponaugle/rsc68k/documents/DRAMTimingSS/LongASCycles/AccessRefreshAccess.png

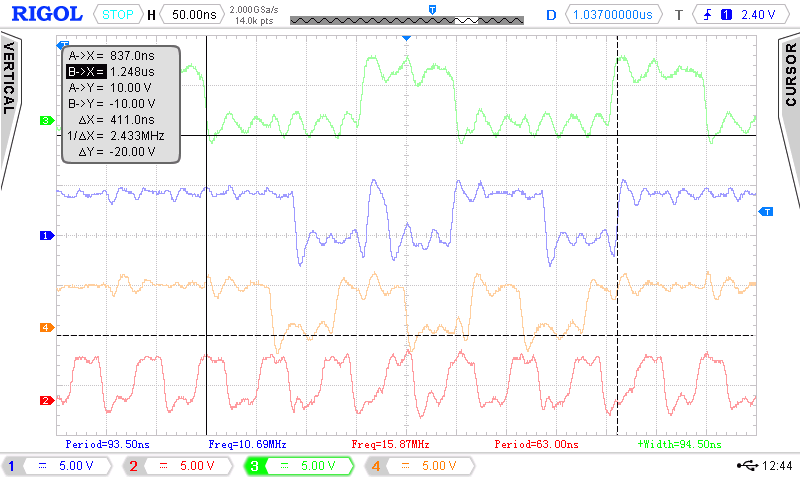
documents/DRAMTimingSS/LongASCycles/AccessRefreshAccess.png
