jeffsponaugle/rsc68k/documents/DRAMTimingSS/LongASCycles/ASHigh470nsRefresh.png

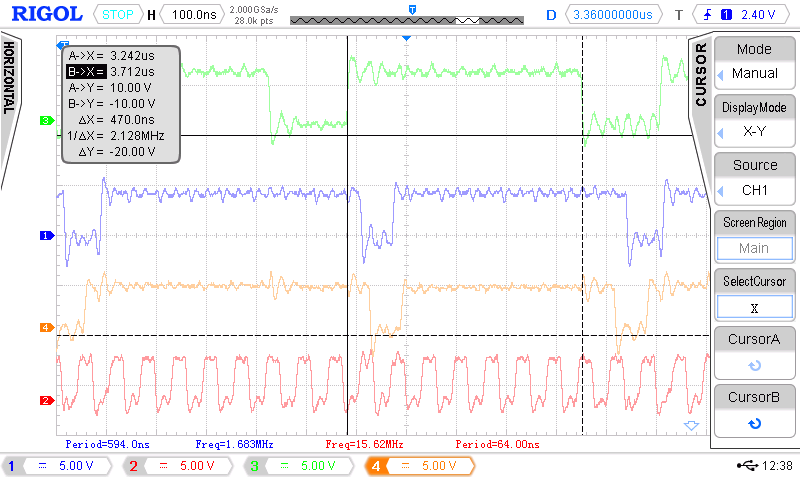
documents/DRAMTimingSS/LongASCycles/ASHigh470nsRefresh.png
