jeffsponaugle/rsc68k/documents/DRAMTimingSS/LongASCycles/ASHigh850ns.png

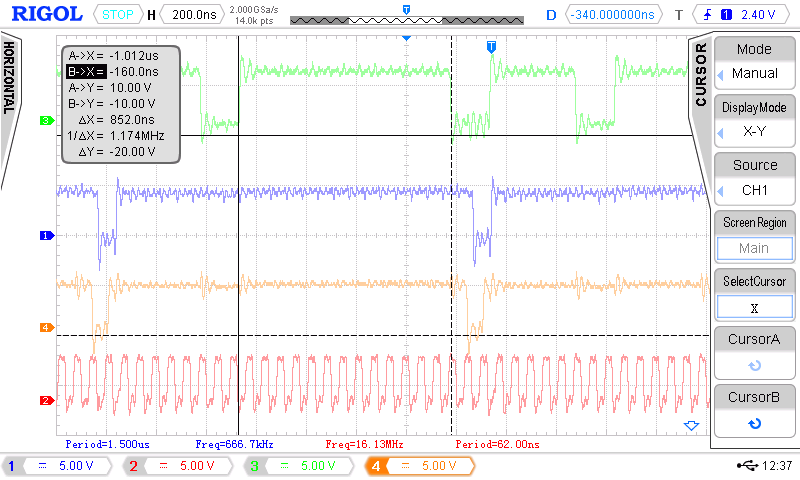
documents/DRAMTimingSS/LongASCycles/ASHigh850ns.png
