jeffsponaugle/rsc68k/documents/DRAMTimingSS/LongASCycles/ASHigh1330ns.png

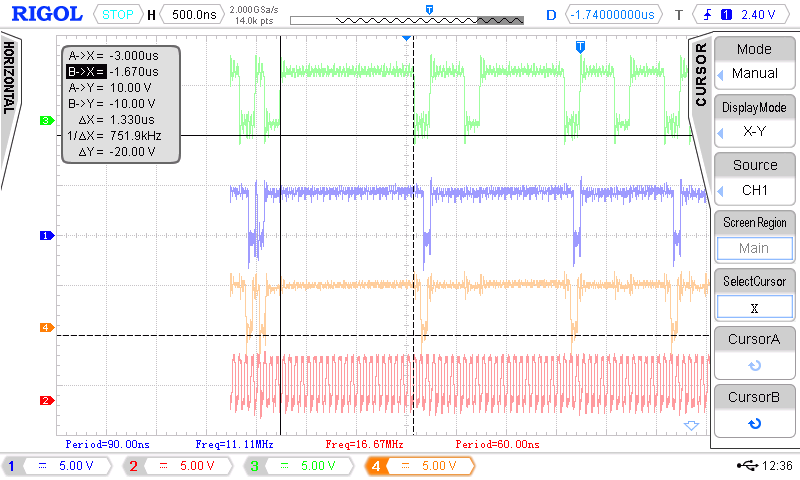
documents/DRAMTimingSS/LongASCycles/ASHigh1330ns.png
