jeffsponaugle/rsc68k/documents/DRAMTimingSS/RefhreshBeforeAcc/ASHighToCASRLow.png

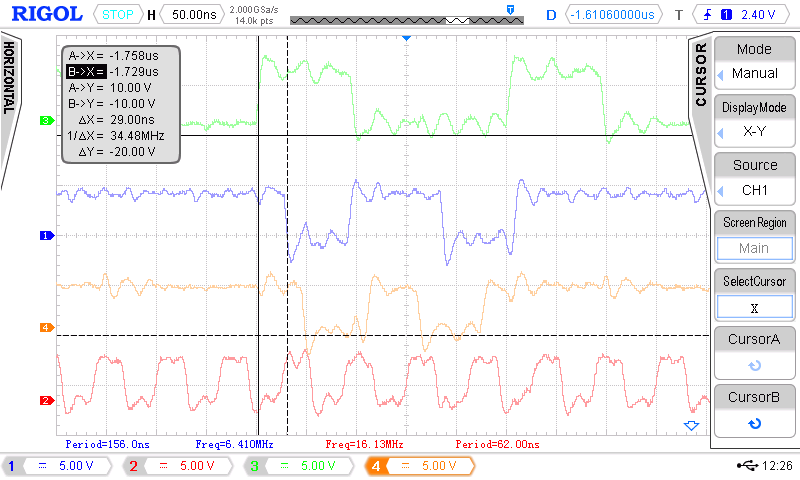
documents/DRAMTimingSS/RefhreshBeforeAcc/ASHighToCASRLow.png
