jeffsponaugle/rsc68k/documents/DRAMTimingSS/RefhreshBeforeAcc/CASRHightoCASLow.png

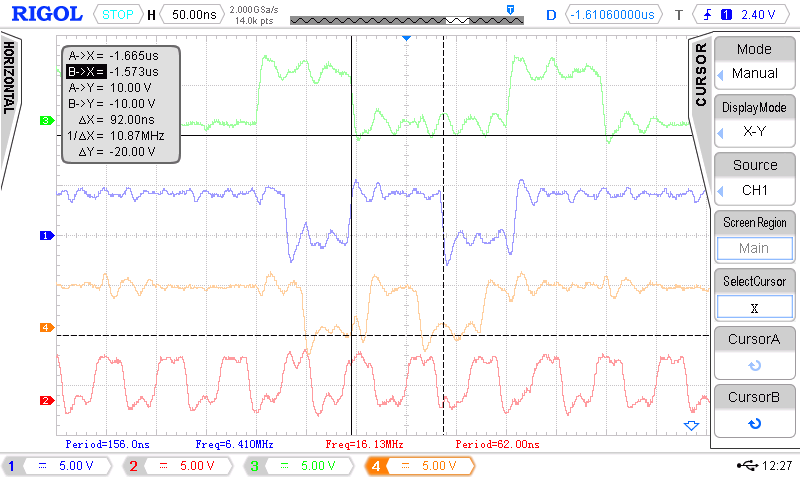
documents/DRAMTimingSS/RefhreshBeforeAcc/CASRHightoCASLow.png
