jeffsponaugle/rsc68k/documents/DRAMTimingSS/RefhreshBeforeAcc/RASRHighToRASLow.png

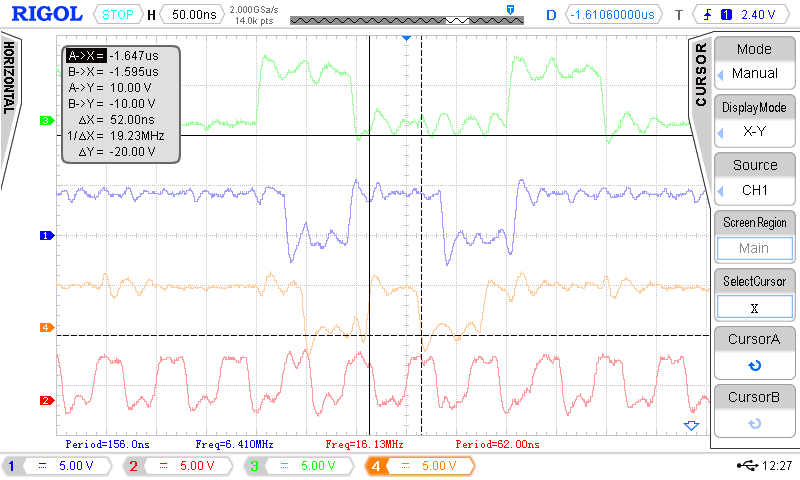
documents/DRAMTimingSS/RefhreshBeforeAcc/RASRHighToRASLow.png
