jeffsponaugle/rsc68k/documents/DRAMv1.png

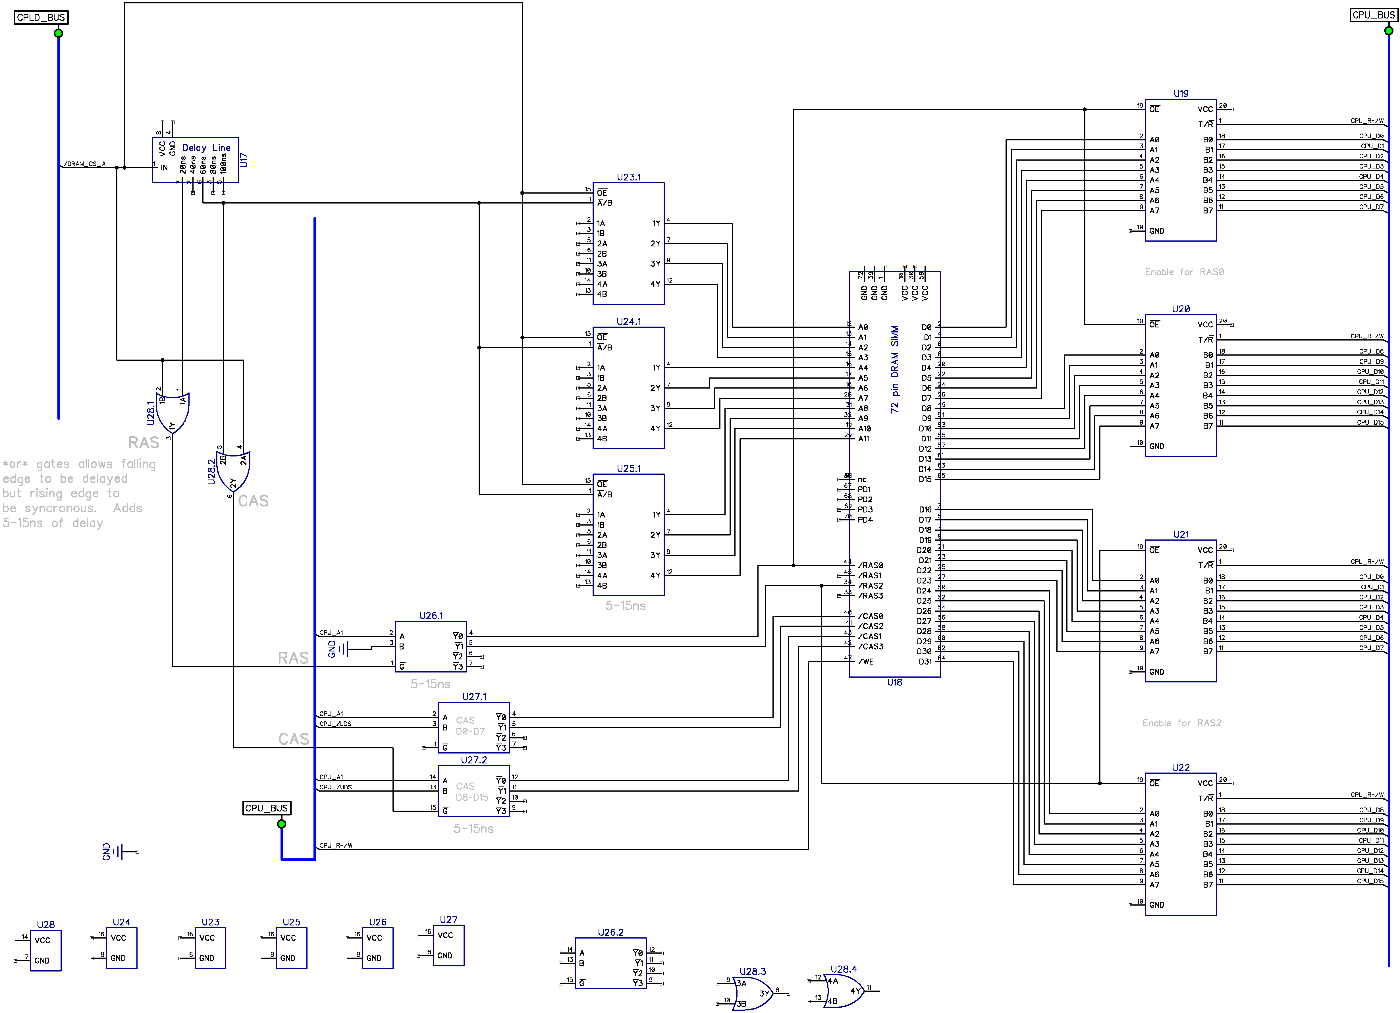
documents/DRAMv1.png
