jeffsponaugle/rsc68k/documents/FLIR0330.jpg

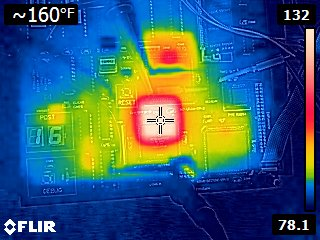
documents/FLIR0330.jpg
