jeffsponaugle/rsc68k/documents/FLIR0336.jpg

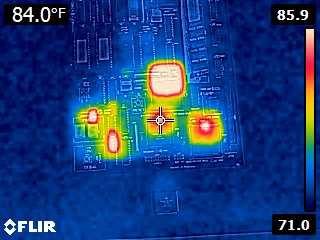
documents/FLIR0336.jpg
