jeffsponaugle/rsc68k/documents/Model100Keymap.png

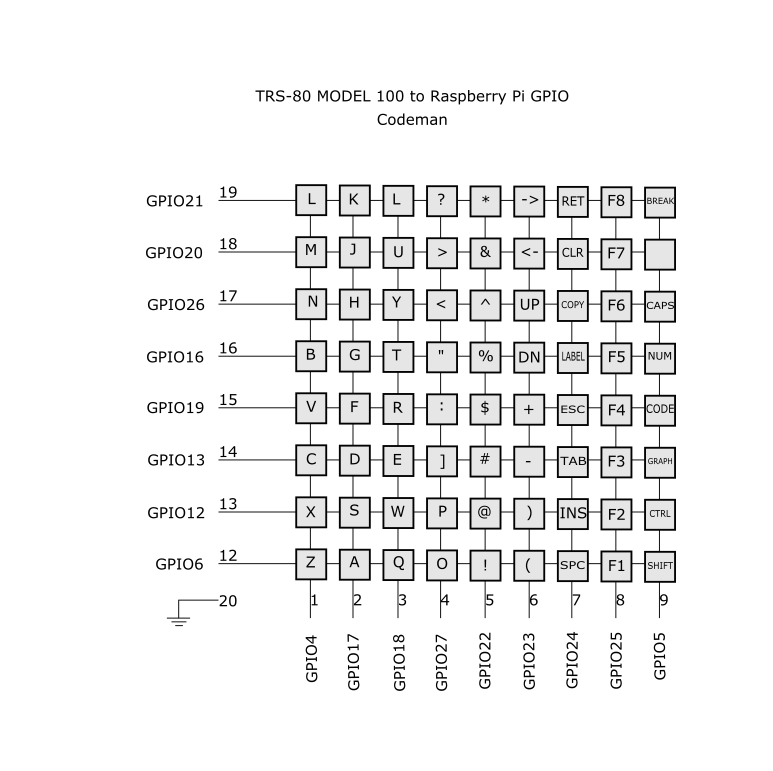
documents/Model100Keymap.png
