jeffsponaugle/rsc68k/documents/NewTimingGen/32I-32O-16I-16O-A.png

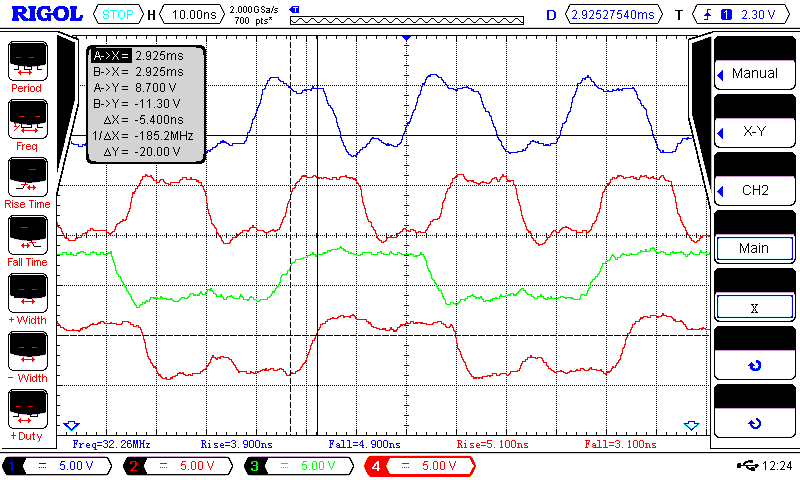
documents/NewTimingGen/32I-32O-16I-16O-A.png
