jeffsponaugle/rsc68k/documents/NewTimingGen/32I-32O-16I-16O-B.png

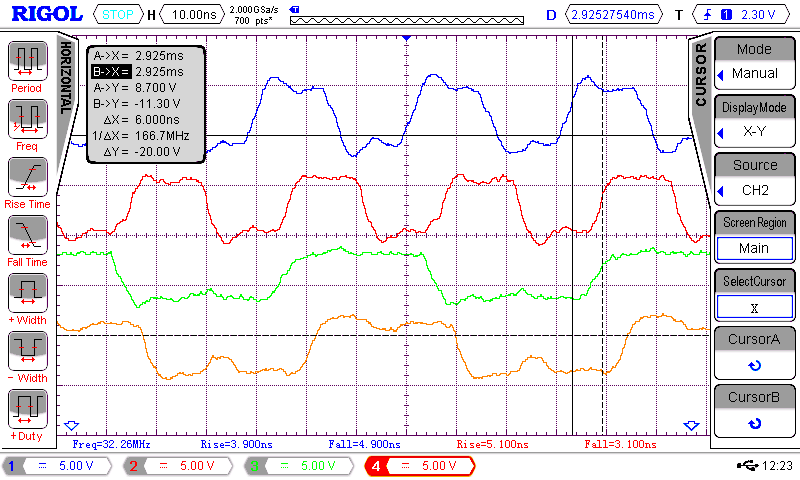
documents/NewTimingGen/32I-32O-16I-16O-B.png
