jeffsponaugle/rsc68k/documents/NewTimingGen/32I-32O-16I-16O-C.png

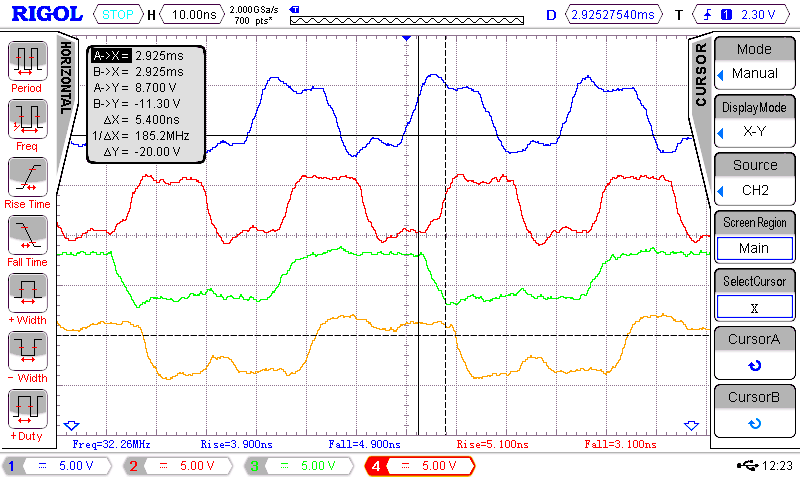
documents/NewTimingGen/32I-32O-16I-16O-C.png
