jeffsponaugle/rsc68k/documents/NewTimingGen/32I-32O-16O-16O-A.png

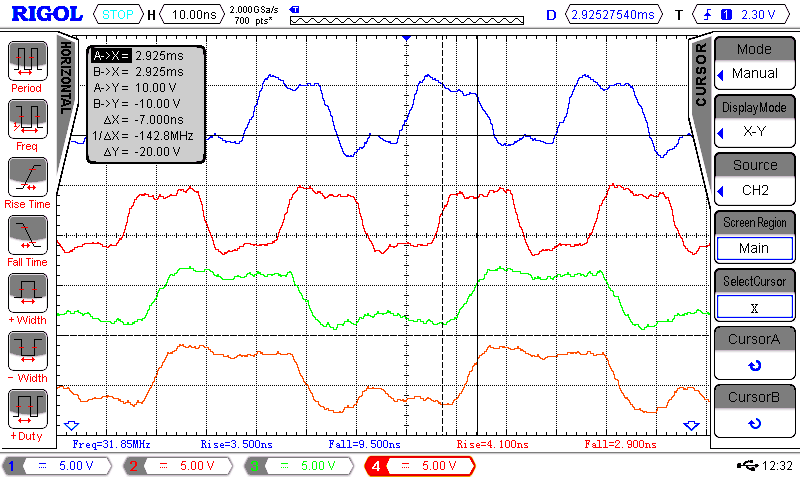
documents/NewTimingGen/32I-32O-16O-16O-A.png
