jeffsponaugle/rsc68k/documents/NewTimingGen/32I-32O-32O.png

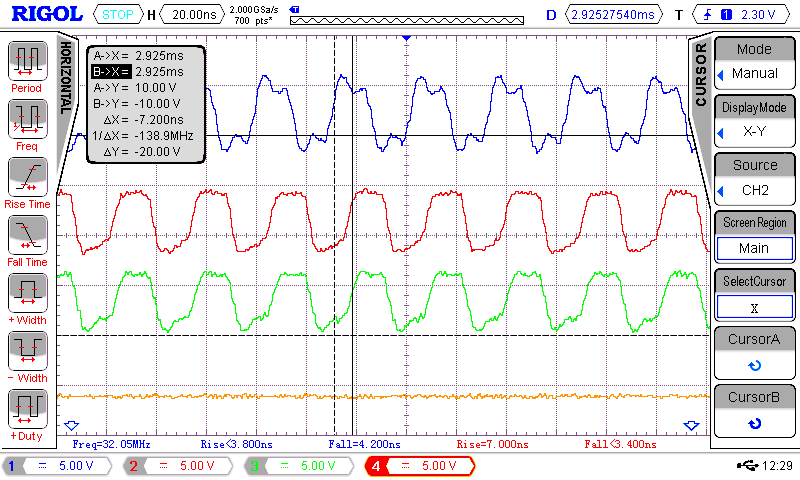
documents/NewTimingGen/32I-32O-32O.png
