jeffsponaugle/rsc68k/documents/Screenshot 2023-06-19 at 3.37.50 PM.jpg

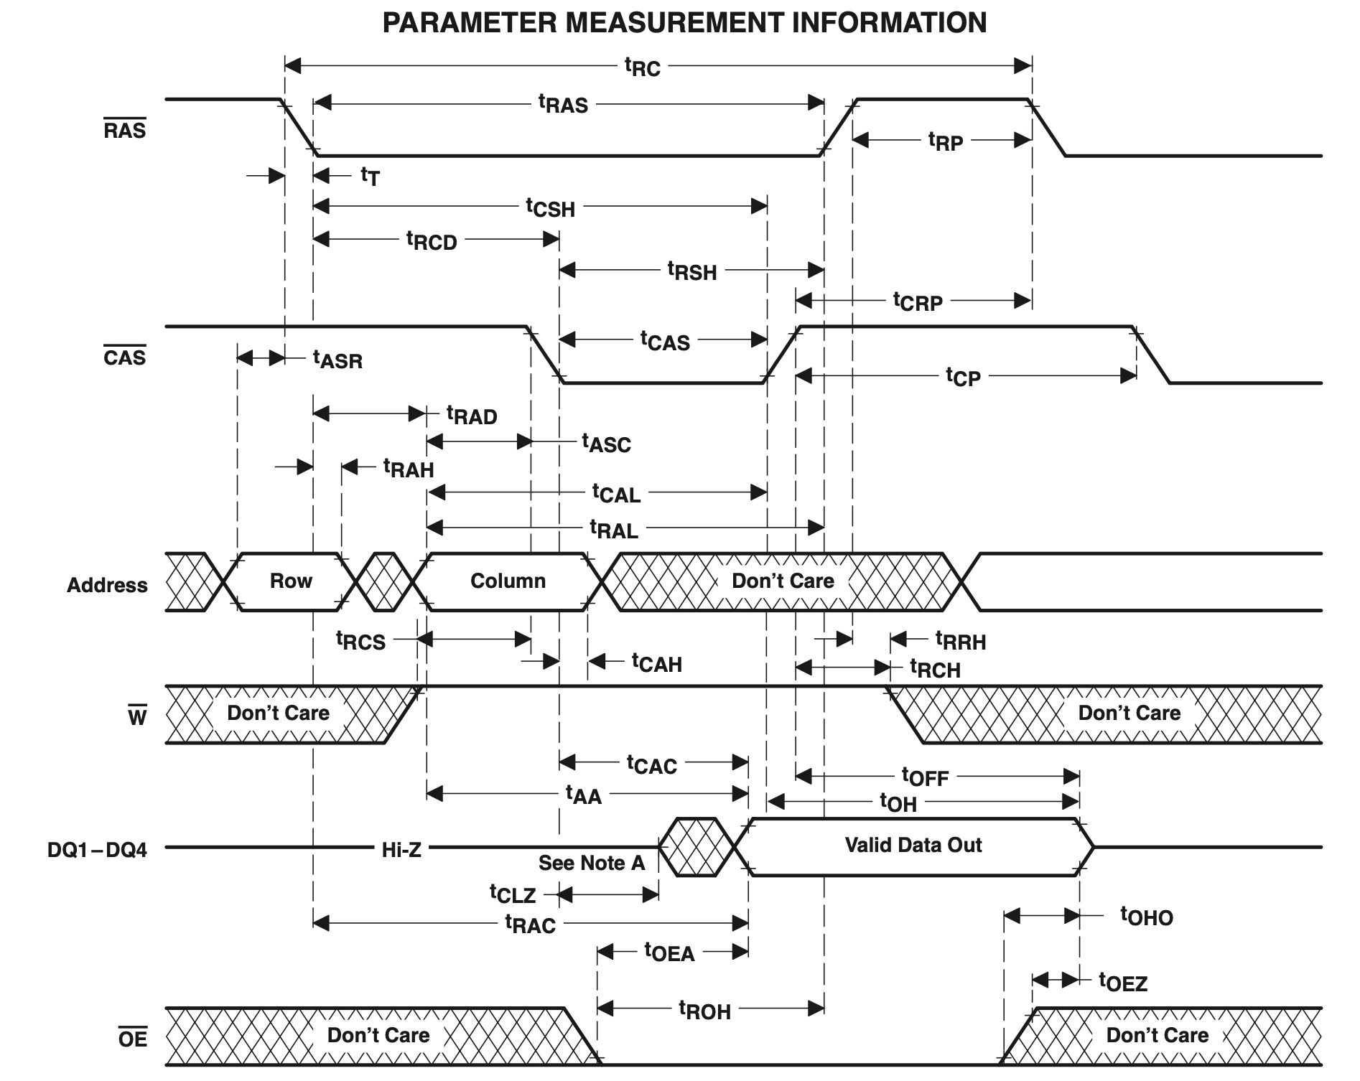
documents/Screenshot 2023-06-19 at 3.37.50 PM.jpg
