jeffsponaugle/rsc68k/documents/Screenshot 2023-06-19 at 3.40.25 PM.jpg

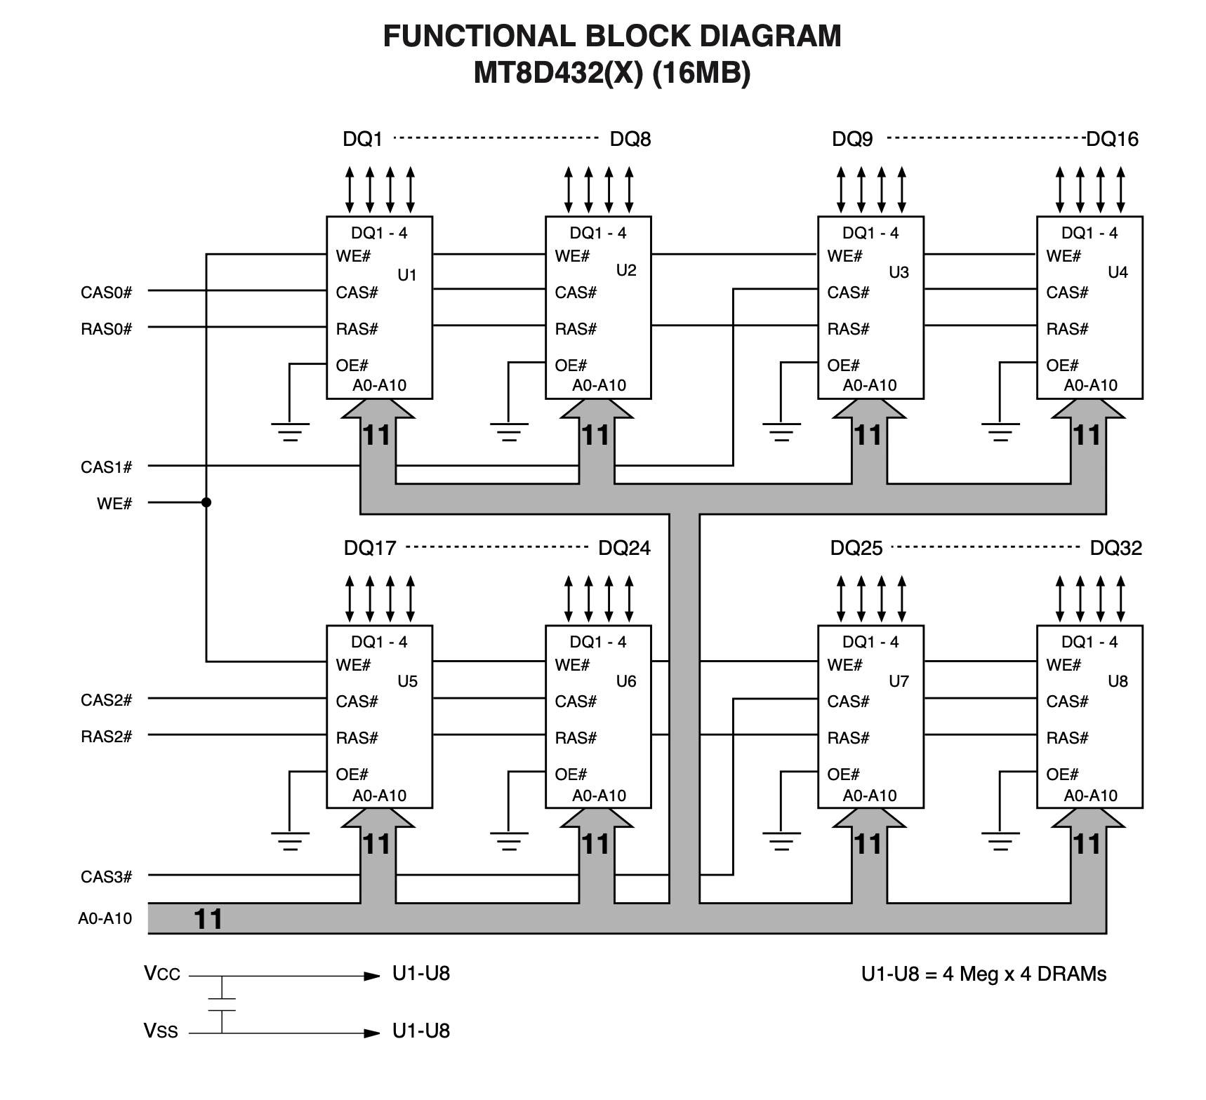
documents/Screenshot 2023-06-19 at 3.40.25 PM.jpg
