jeffsponaugle/rsc68k/documents/Screenshot 2023-06-19 at 3.40.42 PM.jpg

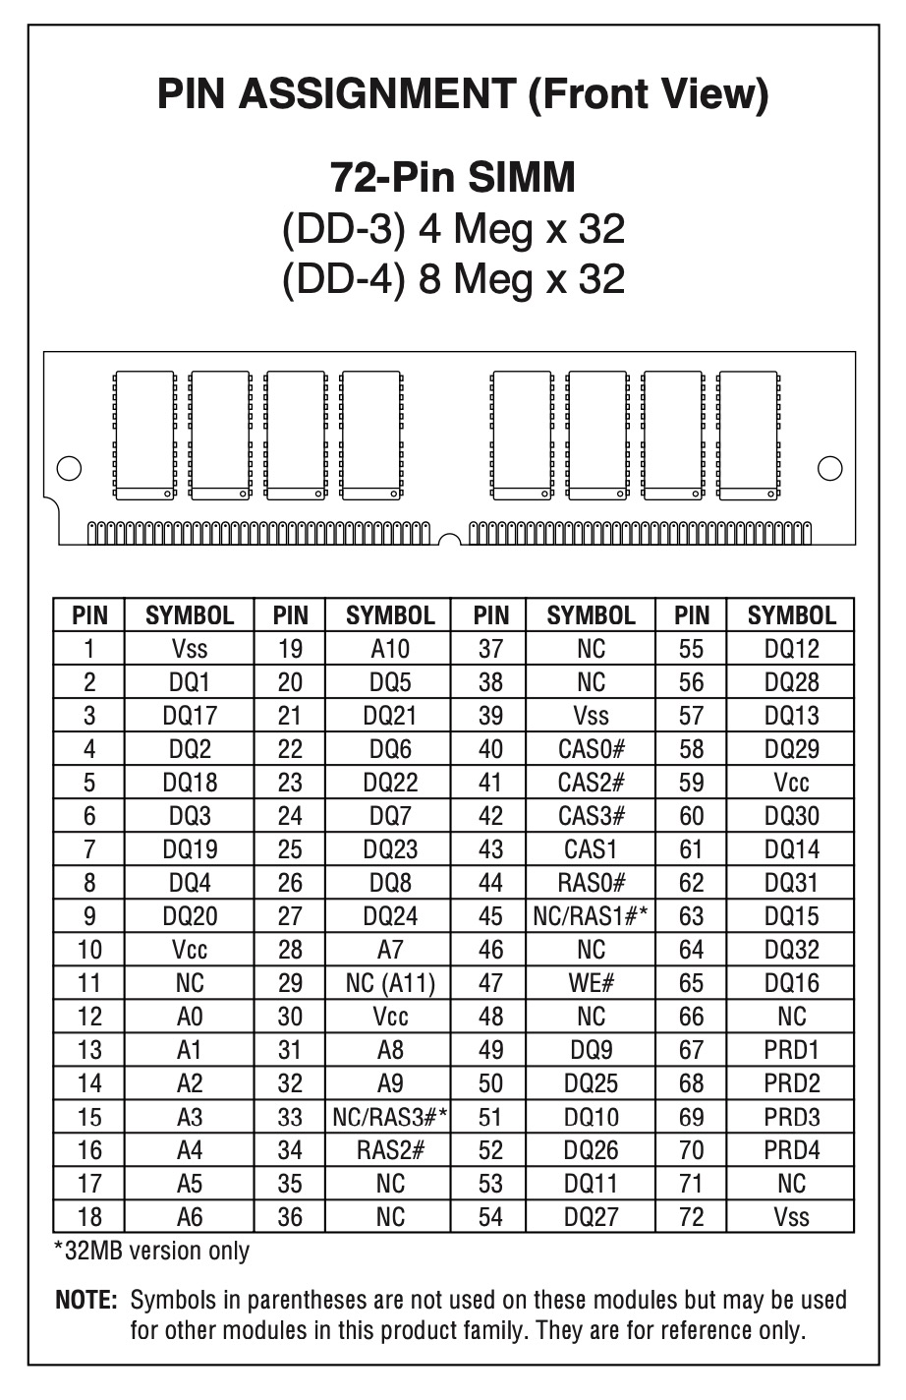
documents/Screenshot 2023-06-19 at 3.40.42 PM.jpg
