jeffsponaugle/rsc68k/documents/toluenestoich.png

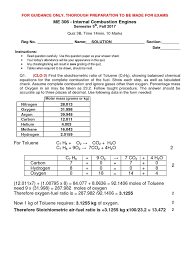
documents/toluenestoich.png
