jeffsponaugle/rsc68k/documents/VGAClocks.jpeg

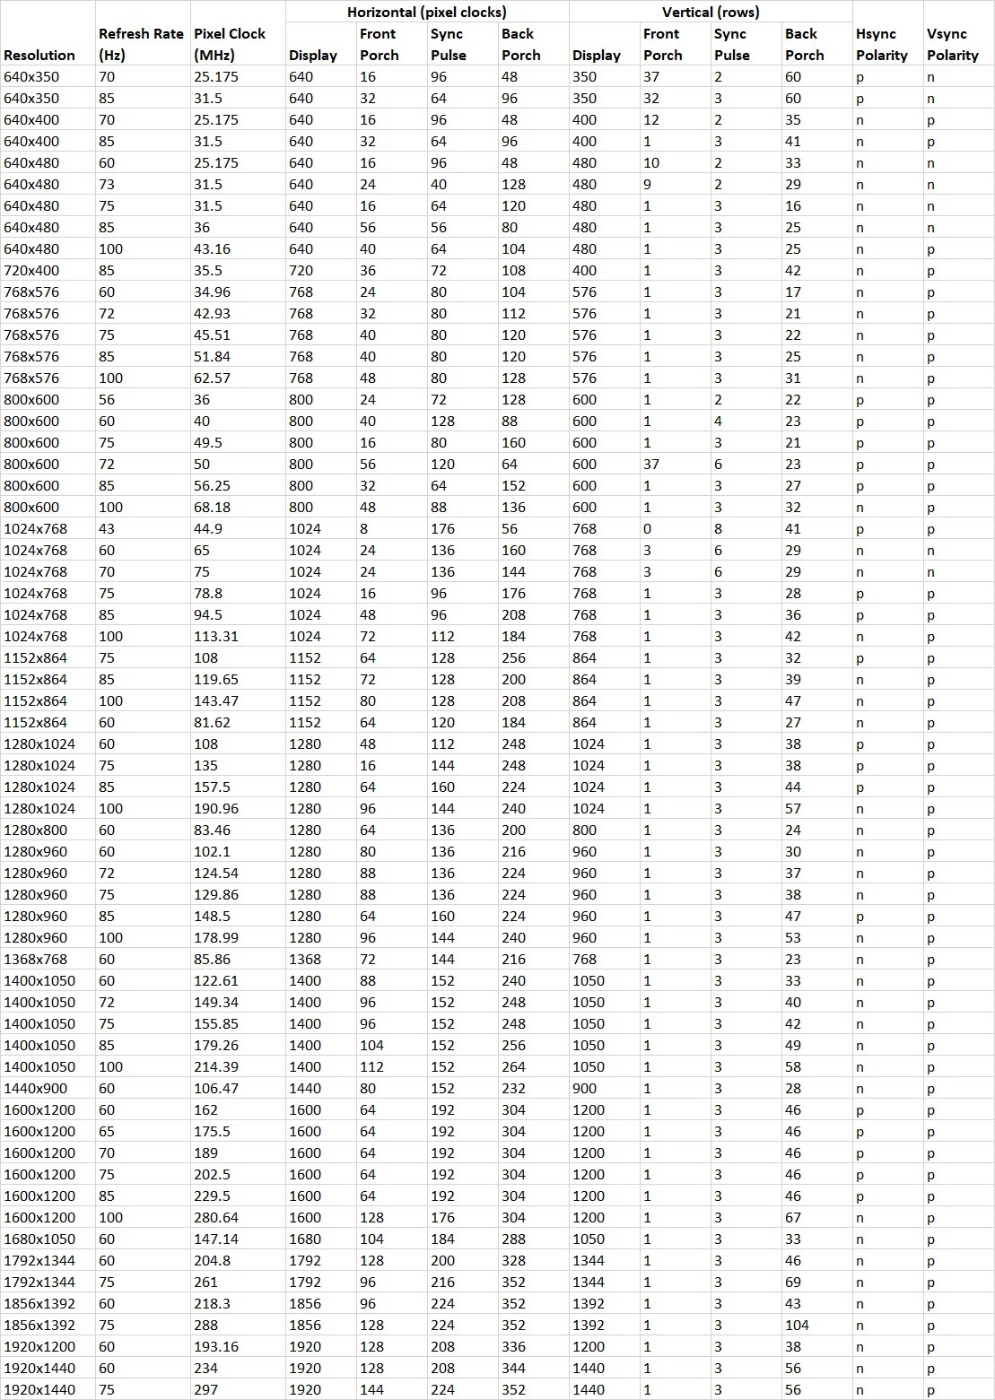
documents/VGAClocks.jpeg
