jeffsponaugle/rsc68k/hardware/diptrace/Projects/VRAMACCESSARB.png

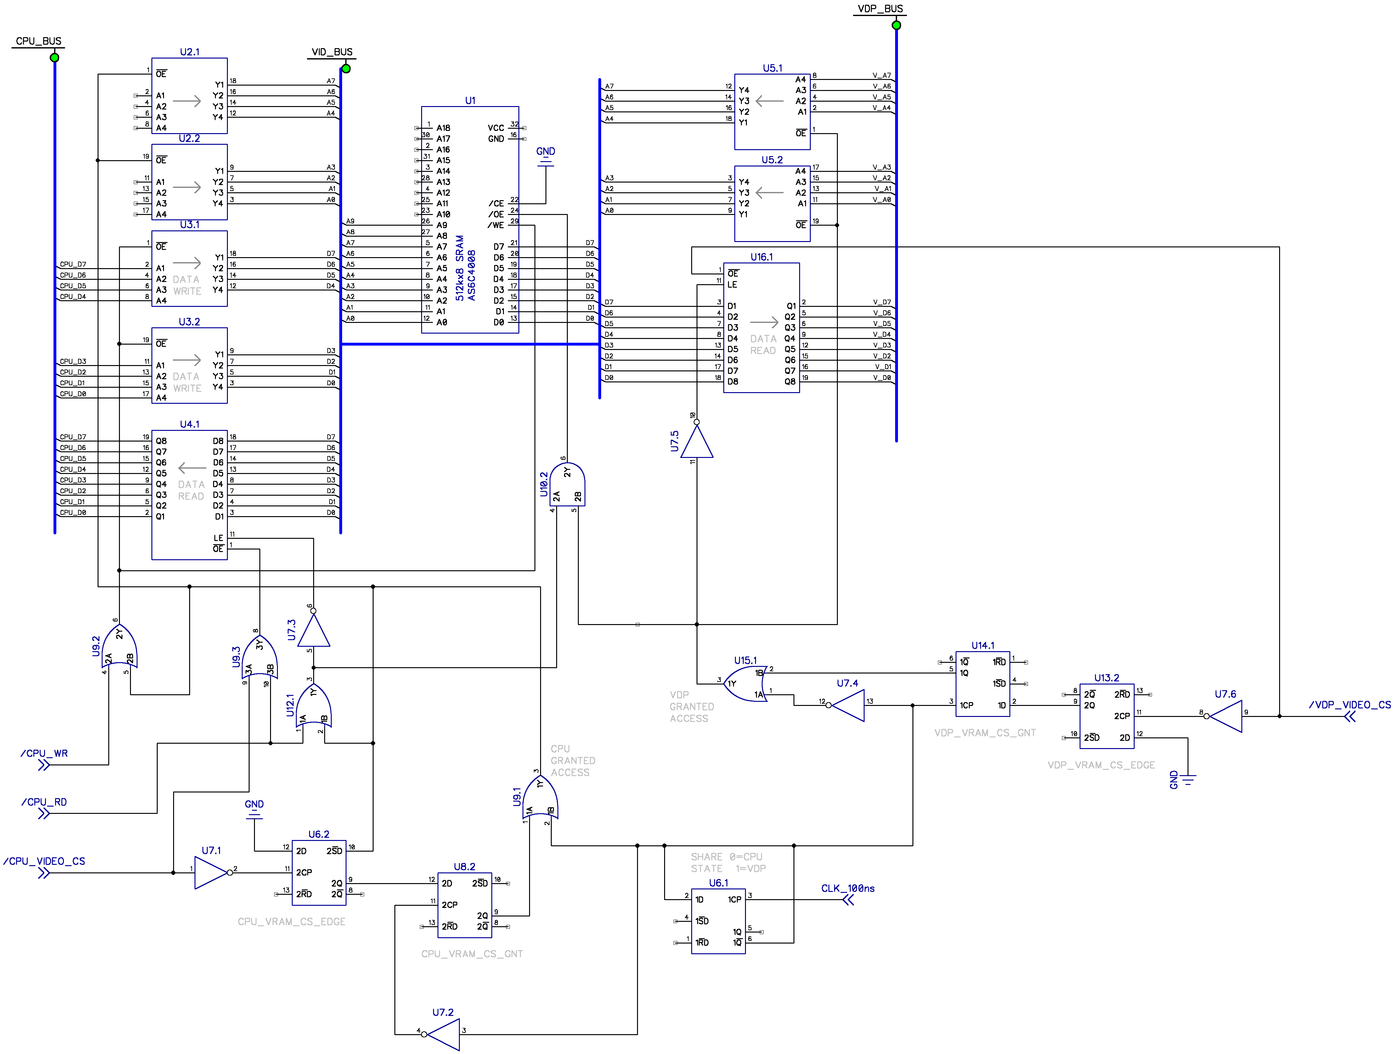
hardware/diptrace/Projects/VRAMACCESSARB.png
