jeffsponaugle/rsc68k/documents/DRAMTimingSS/AccBeforeRefresh/DS4_QuickPrint43.png

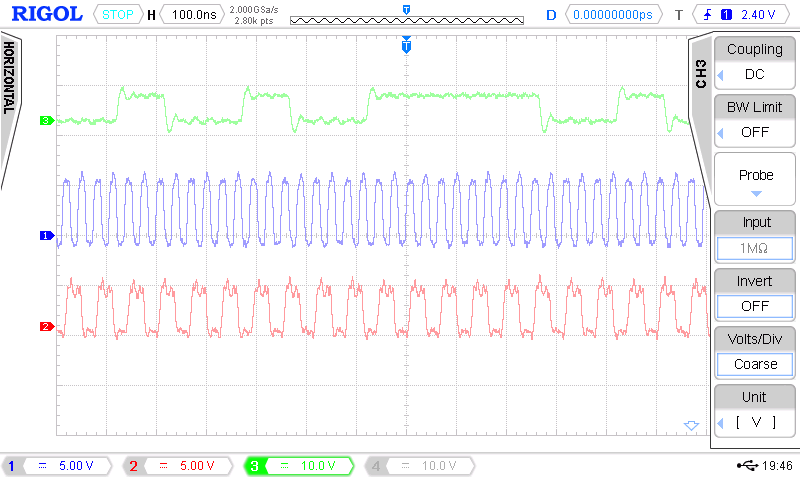
documents/DRAMTimingSS/AccBeforeRefresh/DS4_QuickPrint43.png
