jeffsponaugle/rsc68k/documents/DRAMTimingSS/AccBeforeRefresh/DS4_QuickPrint46.png

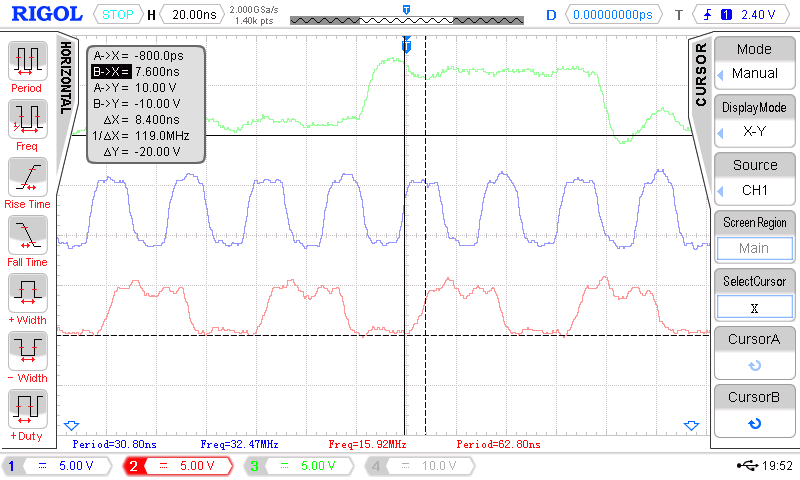
documents/DRAMTimingSS/AccBeforeRefresh/DS4_QuickPrint46.png
