jeffsponaugle/rsc68k/documents/UARTDebugging/FIFO1STOP1aINV.png

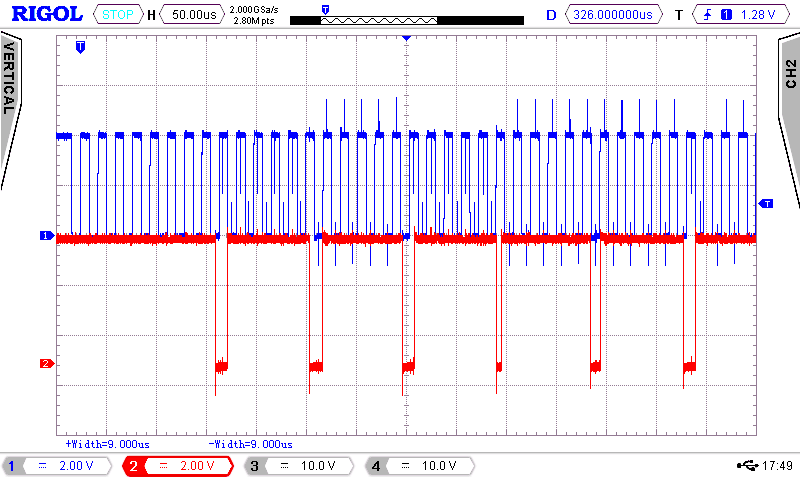
documents/UARTDebugging/FIFO1STOP1aINV.png
