jeffsponaugle/rsc68k/(list of files, drawings)

Other design files:
cpld/TRS80M1-Video2/VDPCPUACCESS.dch
cpld/TRS80M1-Video - Copy/OLD/VDPCPUACCESS.dch
firmware/RSC68k/PowerControlModule/Power Control Module dev board/RSC68k-ATX.dip
firmware/src/RSC68k/PowerControlModule/Power Control Module dev board/RSC68k-ATX.dip
hardware/diptrace/Projects/ATF1508SiimBoard.dch
hardware/diptrace/Projects/ATF1508SiimBoardV2.dch
hardware/diptrace/Projects/ATF1508SimBoard.dip
hardware/diptrace/Projects/ATX_RSC68K_BASEBOARD3_V1.dch
hardware/diptrace/Projects/ATXStartingPCB.dip
hardware/diptrace/Projects/IBM16BMEMCARD.dch
hardware/diptrace/Projects/IBM16MEM.dip
hardware/diptrace/Projects/ISACard.dip
hardware/diptrace/Projects/ISACardProto.dip
hardware/diptrace/Projects/KEYNET.dch
hardware/diptrace/Projects/KEYNET_V2.dch
hardware/diptrace/Projects/RSC68k-ATX (1).dch
hardware/diptrace/Projects/RSC68k-ATX (1).dip
hardware/diptrace/Projects/RSC68K_BASEBOARD2_V1.dch
hardware/diptrace/Projects/RSC68K_BASEBOARD2_V1.dip
hardware/diptrace/Projects/RSC68K_BASEBOARD2_V1_AUTOROUTE.dip
hardware/diptrace/Projects/RSC68K_BASEBOARD2_V1_HANDROUTE.dip
hardware/diptrace/Projects/RSC68K_BASEBOARD2_V1_PREROUTE.dip
hardware/diptrace/Projects/RSC68K_BASEBOARD2_V11.dch
hardware/diptrace/Projects/RSC68K_BASEBOARD_V1.dch
hardware/diptrace/Projects/RSC68K_BASEBOARD_V2.dch
hardware/diptrace/Projects/RSC68K_BASEBOARD_V3.dch
hardware/diptrace/Projects/RSC68K_BASEBOARD_V4.dch
hardware/diptrace/Projects/RSC68K_BASEBOARD_V4.dip
hardware/diptrace/Projects/RSC68K_BASEBOARD_V5_NOL.dch
hardware/diptrace/Projects/RSC68K_BASEBOARD_V5_Poured.dip
hardware/diptrace/Projects/RSC68K_BASEBOARD_V5_PouredCR.dip
hardware/diptrace/Projects/RSC68K_BASEBOARD_V5_ROUTED.dip
hardware/diptrace/Projects/RSC68K_BASEBOARD_V6_NOL.dch
hardware/diptrace/Projects/RSC68K_BASEBOARD_V7.dch
hardware/diptrace/Projects/RSC68K_BASEBOARD_V8.dch
hardware/diptrace/Projects/RSC68K_BASEBOARD_V9.dch
hardware/diptrace/Projects/RSC68K_BASEBOARD_V9_PouredCR.dip
hardware/diptrace/Projects/RSC68K_BASEBOARD_V9_ROUTED.dip
hardware/diptrace/Projects/RSC68K_BASEBOARD_V10.dch
hardware/diptrace/Projects/RSC68K_BASEBOARD_V10_ROUTED.dip
hardware/diptrace/Projects/RSC68K_DRAM_V1.dch
hardware/diptrace/Projects/RSC68K_EXPBOARD2_V1.dch
hardware/diptrace/Projects/RSC68K_EXPBOARD2_V1X.dch
hardware/diptrace/Projects/RSC68K_FIX.dch
hardware/diptrace/Projects/RSC68K_FIX.dip
hardware/diptrace/Projects/RSC68K_KEYNET_V1.dip
hardware/diptrace/Projects/RSC68K_LOGICA2_V1.dch
hardware/diptrace/Projects/RSC68K_LOGICA2_V1.dip
hardware/diptrace/Projects/RSC68K_VGA3_V1.dip
hardware/diptrace/Projects/RSC68K_VGA3_V1_AUTOROUTED.dip
hardware/diptrace/Projects/RSC68K_VGA4_V1.dip
hardware/diptrace/Projects/RSC68K_VGA4_V1_PREROUTED.dip
hardware/diptrace/Projects/RSC68K_VGA4_V1_ROUTED.dip
hardware/diptrace/Projects/RSC68K_VGA5_V1.dip
hardware/diptrace/Projects/RSC68K_VGA5_V1_PREROUTE.dip
hardware/diptrace/Projects/RSC68K_VGA5_V1_ROUTED.dip
hardware/diptrace/Projects/VDPCPUACCESS.dch
hardware/diptrace/Projects/VGA_REV1.dch
hardware/diptrace/Projects/VGA_REV2.dch
hardware/diptrace/Projects/VGA_REV3.dch
hardware/diptrace/Projects/VGA_REV4.dch
hardware/diptrace/Projects/VGA_REV5.dch
hardware/trs80m1/ASBUILT-PROTO1/7SEGPOSTDISP.dch
hardware/trs80m1/ASBUILT-PROTO1/7SegPOSTDisp.dip
hardware/trs80m1/ASBUILT-PROTO1/FLASH_SRAM_ADP.dch
hardware/trs80m1/ASBUILT-PROTO1/FLASH_SRAM_ADP_PREROUTE.dip
hardware/trs80m1/ASBUILT-PROTO1/FLASH_SRAM_ADP_ROUTED.dip
hardware/trs80m1/ASBUILT-PROTO1/TRS80M1_MAINBOARD.dch
hardware/trs80m1/ASBUILT-PROTO1/TRS80M1_MAINBOARD.dip
hardware/trs80m1/ASBUILT-PROTO1/TRS80M1_MAINBOARD_PREROUTE.dip
hardware/trs80m1/ASBUILT-PROTO1/TRS80M1_MAINBOARD_ROUTED.dip
hardware/trs80m1/ASBUILT-PROTO1/TRS80M1VideoCard.dch
hardware/trs80m1/ASBUILT-PROTO1/TRS80M1VideoPCB.dip
hardware/trs80m1/ASBUILT-PROTO1/TRS80M1VideoPCB_PREROUTE.dip
hardware/trs80m1/ASBUILT-PROTO1/TRS80M1VideoPCB_ROUTED.dip
hardware/trs80m1/TRS80M1_MAINBOARD.dch
hardware/trs80m1/TRS80M1_MAINBOARD.dip
