jeffsponaugle/rsc68k/(commit log)

2022-05-31 Added FLASH sourcecode from svn
    [mkfs.xlsx]
2022-06-02 disable int data driver
2022-06-02 disable int data driver a
2022-06-05 fixed uart
2022-06-07 Removed UART Hack
2022-06-09 Added ResetINV pin 75 Intdram
2022-06-09 Added ResetINV pin 75 IntdramR
2022-06-09 Added ResetINV pin 75 IntdramRX
2022-06-10 enabled int bus driver
2022-06-20 ASGated Output pin 76
2022-06-22 Removed NIC And K8042 mappings, added INT_DSWAP pin 76
2022-07-03 D7 Update
    Update D7 pin number
2022-08-25 Update INTDRAM.PLD
    fix interrupts.
2022-08-26 fixed uartts
    Fixed UART5 inputs.
2022-09-11 Added VPA pin
2022-09-15 Changed interrupt field names
    Field names for interrupts changed to actual source names, plus some limited VPA assert support added but not enabled.
2022-09-18 UART fix
    Delay UART CS until UDS low to fix write/read problem.
2023-01-27 Added Power Control lines to intdram2
2023-01-27 Added Power Control lines interrupt
2023-01-27 Added Power Control lines interrupt - Fixed
2023-02-02 Added Power Control lines interrupt - Fixed IPL2
2023-02-02 Added Power Control lines interrupt - Fixed IPL2x
2023-04-22 Updated with firmware src
    [RSC68k-ATX.dch, RSC68k-ATX.dip, mkfs.xlsx]
2023-05-04 Added Hardware
    [ATF1508SiimBoard.dch, ATF1508SiimBoardV2.dch, ATF1508SimBoard.dip, IBM16BMEMCARD.dch, IBM16MEM.dip, ISACard.dip, ISACardProto.dip, KEYNET.dch]
2023-05-09 Fixed Keyboard Interrupt to EdgeTrigger
2023-05-31 new CPLDS for ATX PCB
2023-05-31 new CPLDS for ATX PCB v2
2023-06-01 new CPLDS for ATX PCB v3
2023-06-01 new CPLDS for ATX PCB v4
2023-06-01 new CPLDS for ATX PCB v5
2023-06-01 new CPLDS for ATX PCB v7
2023-06-01 new CPLDS for ATX PCB v8
2023-06-02 new CPLDS for ATX PCB v9
2023-06-02 new CPLDS for ATX PCB v10
2023-06-02 new CPLDS for ATX PCB v11
2023-06-03 added documents
    [ATXStartingPCB.dip]
